MatheusParre/Bobinadeira/README.md

# Bobinadeira Horizontal

## Objetivo

Este projeto tem o objetivo de desenvolver uma bobinadeira horizontal e para tal, se encontram neste repositório remoto, todos os resultados obtidos com esse trabalho.

Neste projeto, foi necessário dimensionar todos os componente mecânicos e alguns elétricos (motor elétrico, por exemplo) agindo sempre de acordo com as normas nacionais e internacionais, a fim de padronizar e tornar este um projeto viável e possível no meio industrial atual.

## Monografia

Na monografia se encontram todos os cálculos realizados para o dimensionamento do maquinário de forma mais detalhada e técnica. Este documento foi desenvolvido baseado nas normas abnt atuais  para efeito de padronização e tambem para devida aceitação acadêmica.

Norma abnt p/ formatação do documento: :link: (*<https://www.normasabnt.org/novas-regras-abnt-2021/>*)

## Desenhos

Neste repositório, tambem estão armazenadas todas as **imagens dos componentes** (a maior parte no formato PDF ) cotados em escala, perspectiva e com seus respectivos cabeçalhos e dimensionamentos.

## Componentes

Neste diretório contém os todos as partes mecânincas que compõem o projeto, como por exemplo, **motor**, **mancal**, **rolamento** e **polia**. 
Este caminho também acompanha os arquivos no formato cad e pdf dos desenhos.
