MatheusParre/Bobinadeira/Monografia/Memorial de Cálculos.pdf

Construções de Máquinas I | Projeto: BOBINADEIRA HORIZONTAL
Aluno: Matheus Parré Rozatti
FATEC – Faculdade de Tecnologia de Sorocaba | 1° Semestre 2021

# CONSTRUÇÃO DE MÁQUINAS I

# BOBINADEIRA HORIZONTAL PARA FITAS DE AÇO

Professor: José Antônio Esquerdo Lopes

Aluno: Matheus Parré Rozatti Matrícula: 0030991921004

ANEXOS:

DESENHOS: DAS POLIAS, DO EIXO, DO CONJUNTO DE ACIONAMENTO

DOCUMENTOS CORRIGIDOS E COMENTADOS PELO PROFESSOR NAS VERIFICAÇÕES PARCIAIS:

(HISTÓRICO DO DESENVOLVIMENTO DO TRABALHO AO LONGO DO SEMESTRE)

### 1. DADOS DO PROJETO:

Bobinadeira Horizontal para Fitas de Aço

Dados: Espessura da fita: 0,6mm (h)

Largura da fita: 300mm (b)

Comprimento da fita: 170m (L)

Material da fita: 1020 SAE / ABNT

Velocidade de enrolamento: 0,7m/s

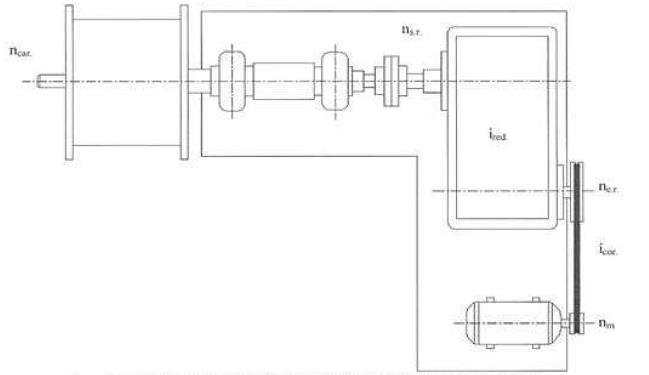
[picture p1: figure]

### 2. CÁLCULO DO RAIO MÍNIMO:

R ≥

H ( E− σesc)
2 .σesc

=

0,6 ( 2,1 . 10⁶− 2100)

2 .2100

= 29,97cm

Logo, R ≥ 29,97cm

### 3. CÁLCULO DA FORÇA DE DOBRAMENTO:

FD =

σesc . B . H
4

=

2100 . 0,6 . 300
4

= 945kgf

### 4. CÁLCULO DAS DIMENSÕES DA BOBINA:

Utilizando o raio do diâmetro interno d obtemos:

d = 29,47 x 2 = 58.94cm

### 5. CÁLCULO DO DIÂMETRO EXTERNO:

D = 2 x √
(l . ℎ)
π

+ r

2 = 2 x √
(17000 . 0,06)
π

+ 29,97² = 69,94cm

### 6. CÁLCULO DO DIÂMETRO MÉDIO:

Dm = D+d
2

=

69,94 +58,94
2

= 64,94cm

### 7. CÁLCULO DA POTÊNCIA ÚTIL OU EFETIVA:

Nu = 2 . v . Fd . D
75 . ( D+d)

=

2 . 0,7 . 945 . 69,94
75 . ( 69,94 + 59,94)

= 9,50 CV

### 8. CÁLCULO DO RENDIMENTO TOTAL:

ηROL = rendimento por mancal / rolamento = 0,99 ηCORR = rendimento na transmissão por correia = 0,95 ηRED = rendimento do redutor = 0,95
ηACOP = rendimento do acoplamento = 0,95

ηtotal = ηROL . ηROL . ηCORR . ηRED . ηACOP = 0,99 . 0,99 . 0,95 . 0,95 . 0,95 = 0,84

### 9. CÁLCULO DA POTÊNCIA FORNECIDA PELO DO MOTOR:

ηf = Nu
ηtotal =

9,50
0,84

= 11,31 CV

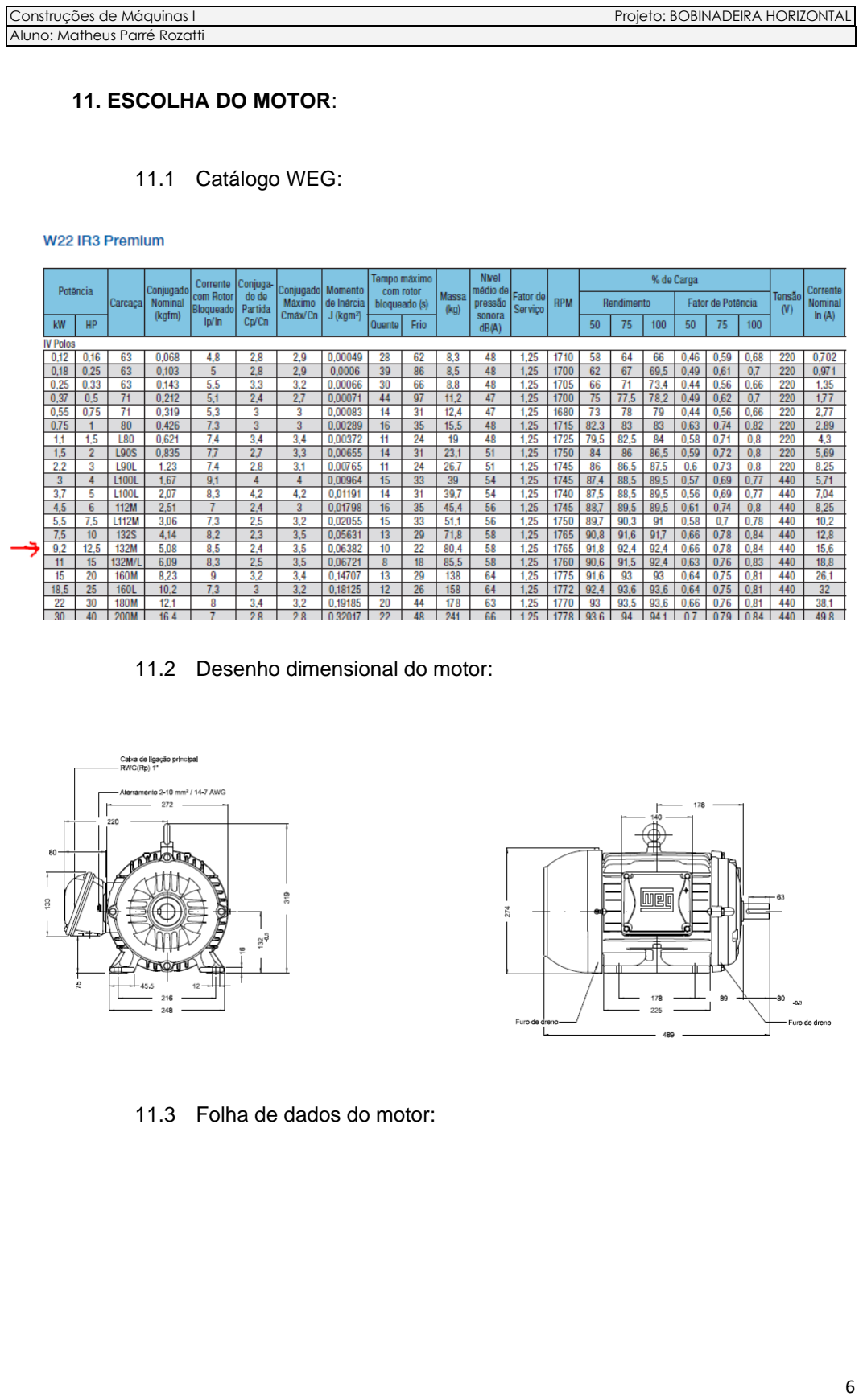
[picture p2: page 6]

### 11. ESCOLHA DO MOTOR:

11.1 Catálogo WEG:

11.2 Desenho dimensional do motor:

11.3 Folha de dados do motor:

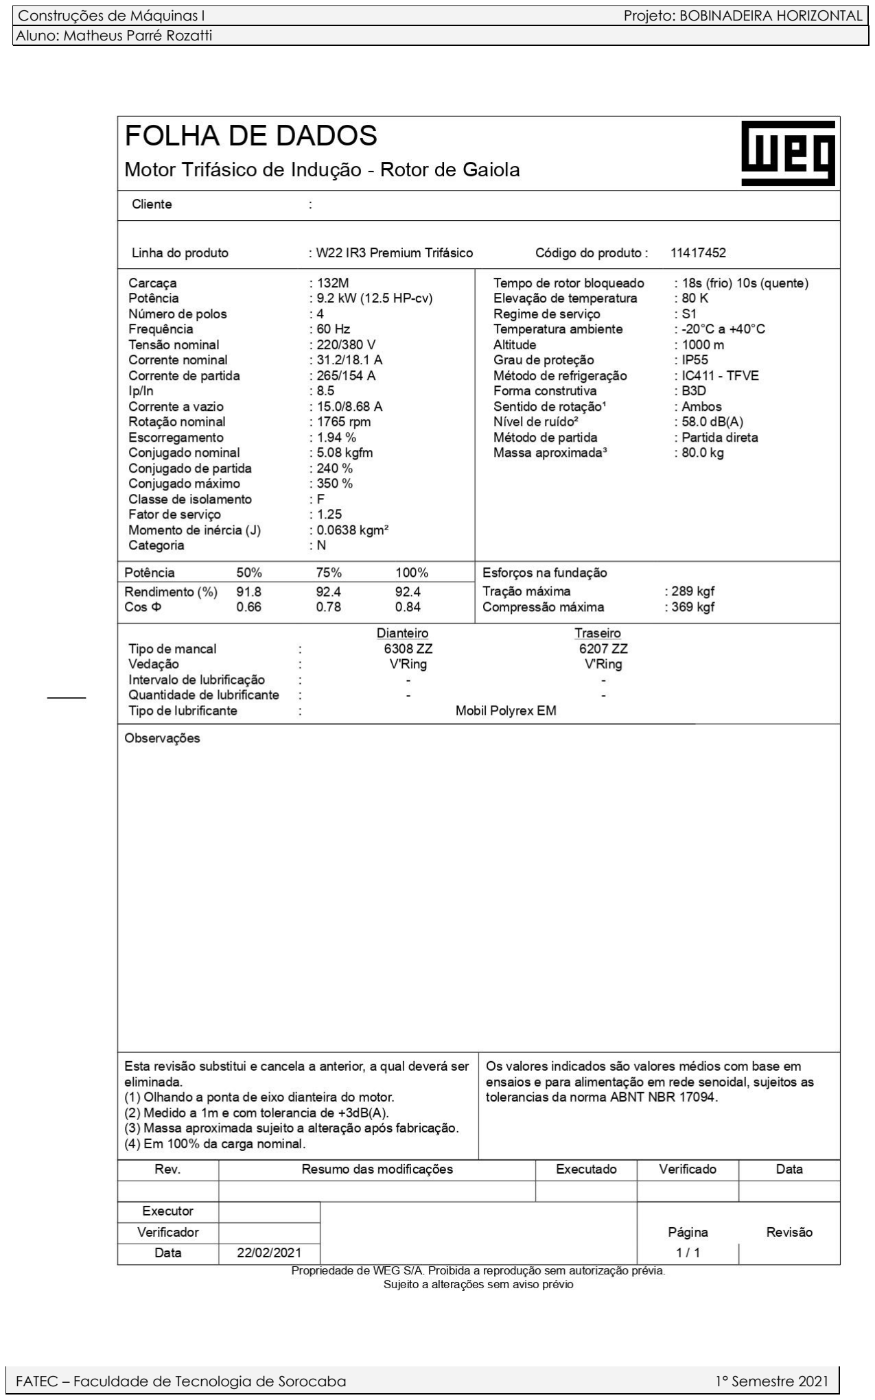
[picture p3: page 7]

### 12. CÁLCULO DA PARA DETERMINAR O REDUTOR A SER UTILIZADO NO

PROJETO:

12.1. DADOS:
Tipo de máquina: Bobinadeira
Ciclo de operação: Serviço contínuo até 12 horas / dia Potência do motor instalado: Pa = 9,2 kw Temperatura média do ambiente: 30 ºC
Altitude do ambiente: 800 m
Tipo de partida: direta
Frequência de partida: 10 / hora

Rotação do eixo de entrada do redutor: n1 Rotação do eixo de saída do redutor: n2

12.2. Determinação da relação de velocidade do redutor:

Para conseguir determinar a relação de velocidade do motor é necessário primeiro

achar n1 e n2

n1 = Rotação nominal do motor 3

=

1765
3

= 588,33 rpm

Para achar o n2 é necessário calcular a rotação do carretel:

n2= 19100 . v
dm

=

19100 . 0,7
64,94

= 20,59 rpm

Com isso já é possível determinar a relação de velocidade:

Ir =n1
n2

=

588,33
20,59

= 28,57

Por questões comerciais, da qual não existe um redutor de 28,57 e o mais próximo

é o 28, então é adotado o valor de 28 para ralação de velocidade.

12.3. Verificação da capacidade de Potência Mecânica do Redutor:
Pn = Pa x Fs ≤ Pr | Pr = | n1 n1 tabela
. p1

Alguns dados serão obtidos pelas tabelas da WEG Cestari, tabelas que apresentarei

ao decorrer dos cálculos. Vamos primeiro fazer o cálculo da capacidade de potência

mecânica do redutor em função da rotação de entrada (Pr), | para | isso | vamos

consultar a tabela da página 17.

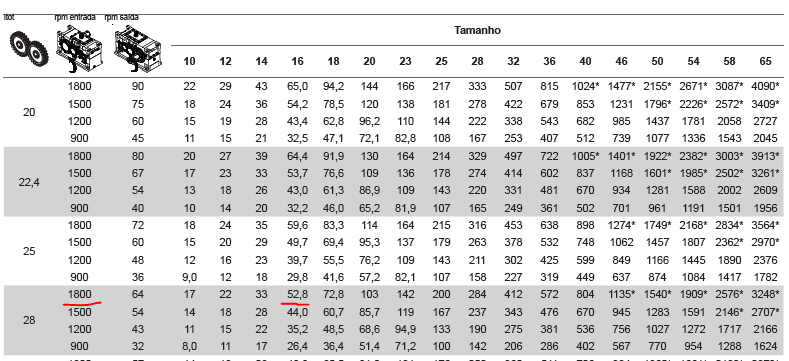
[picture p4: figure]

O valor de 1800 rpm foi escolhido por ser o mais próximo ao do motor já definido de

1765 rpm e, a carcaça de 16 foi escolhida pois é a que consegue suportar a

capacidade de torque do motor que calcularemos mais para frente, por conta disso

não utilizamos a de 14, já que ela não atende a condição de torque. Com esses

valores definidos podemos começar a resolver a equação.

Pr = n1 n1 tabela

x p1 = 588,33
1800

x 52,8 = 17,26

Para fazer o cálculo da potência nominal (Pn) será necessário olhar na tabela 1 de

fatores de segurança da página 7 do catálogo.

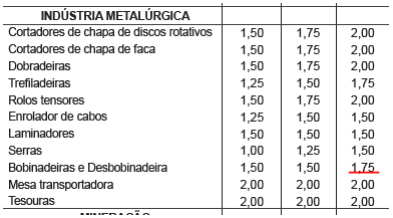
[picture p5: figure]

Sabendo que a bobinadeira vai trabalhar por 12 horas contínuas por dia é adotado o

fator de segurança (Fs) de 1,75.

Pn = Pa. Fs = 9,2 x 1,75 = 16,1 Kw

Pn ≤ Pr = 16.1 ≤ 17,26

Logo a carcaça de 16 atende a condição de potência mecânica do redutor.

12.4. Verificação da capacidade de Potência Térmica do Redutor:

Pt = Ptg x Fa x Fh ≥ Pa

Para acharmos os valores da potência térmica do redutor (Ptg), fator temperatura

ambiente (Fa) e o fator altitude (Fh) teremos que olhar em diversas tabelas, todas

serão apresentadas pela ordem escrita aqui.

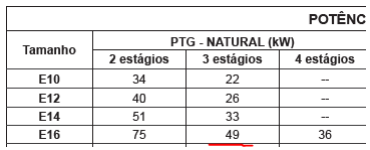
[picture p6: figure]

O Ptg foi retirado da página 10 usando como base o tamanho 16 da carcaça, já o Fa

foi retirado da página 8 utilizando como fato o dado que a temperatura ambiente é

de 30°C e por último o Fh também foi retirado da página 8, também utilizando de um

dado já apresentado que a altitude seria de 800m. Com todos esses dados, podemos

prosseguir com a equação.

Pt = Ptg x Fa x Fh = 49 x 0,85 x 1 = 41,65

Pn ≥ Pa = 41,62 ≥ 9.2

Logo, a potência térmica do redutor atende as necessidades.

12.5. Verificação da capacidade de torque do redutor em operação:

Como nossa carga é constante usaremos a seguinte equação:

Mn2 = 9550 x Pn
n2

= 9550 x 16,1
20,59

= 7467,46 Nm

Para verificar se o redutor atende as necessidades de torque usaremos a seguinte

equação:

M2 ≥ Mn2

M2 é um dado que devemos tirar da página 15 do catálogo.

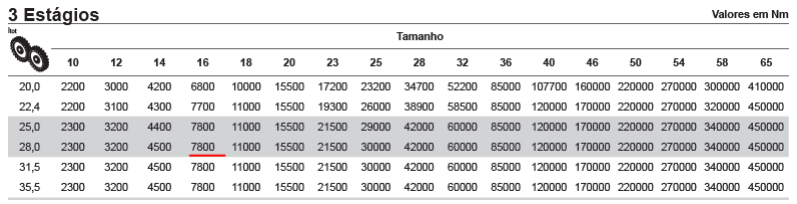
[picture p7: figure]

M2 ≥ Mn2 = 7800 ≥ 7467,46 Nm

Logo, o redutor atende a condição de torque.

12.6. Verificação da capacidade de torque do redutor na partida:

Como já dito, pelo fato de a carga ser constante usaremos a seguinte fórmula.

Mk2 adm = 2 . Mn2
Ff

O fator pico de partida (Ff) é um dado proveniente da página 8 do catálogo.

Utilizando o dado que já havia sido nos oferecido, que dizia que a partida era direta

e a bobinadeira trabalha de forma contínua por 12 horas, utilizamos um Ff de 1.2.

Mk2 adm = 2 . Mn2
Ff

=

2 . 7467,46
1,2

= 12445,77 Nm

Para realizarmos a conferência, se o redutor atende as necessidades utilizaremos a

seguinte equação:

Mk2 adm ≥ Mk2 máx.

Mas antes disso precisamos achar Mk2 máx.

Mk2 máx = 9550 x Pa
n2

x Fp

Fp é o fator de partida que deve ser retirado do catálogo, na página 8.

Como já havia sido dito que a partida é direta, vamos utilizar o Fp de 3.

Mk2 máx = 9550 x Pa
n2

x Fp = 9550 x 9,2
20,59

x 3 = 12801,36 Nm

Mk2 adm ≥ Mk2 máx = 12445,77 ≥ 12801,36

Como nesse caso as condições não foram atendidas faremos usaremos a seguinte

fórmula.

M2 ≥ Mk2 máx

Utilizaremos uma tabela, para achar o M2 que seja maior do que 12801,36.

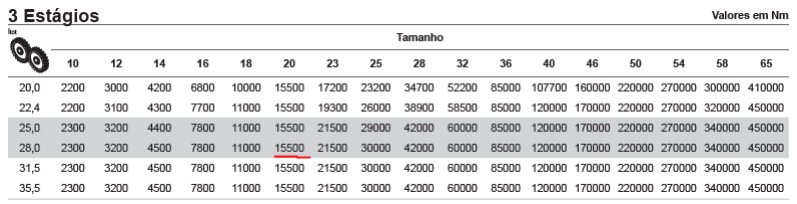
[picture p8: figure]

Logo, o redutor de 16 deverá ser substituído por um de 20.

12.7. Definição do código do redutor:

E – 20 – 3 – 29 – P – 19 – 0 – 0 – 0 - K

12.8. Desenho dimensional do redutor:

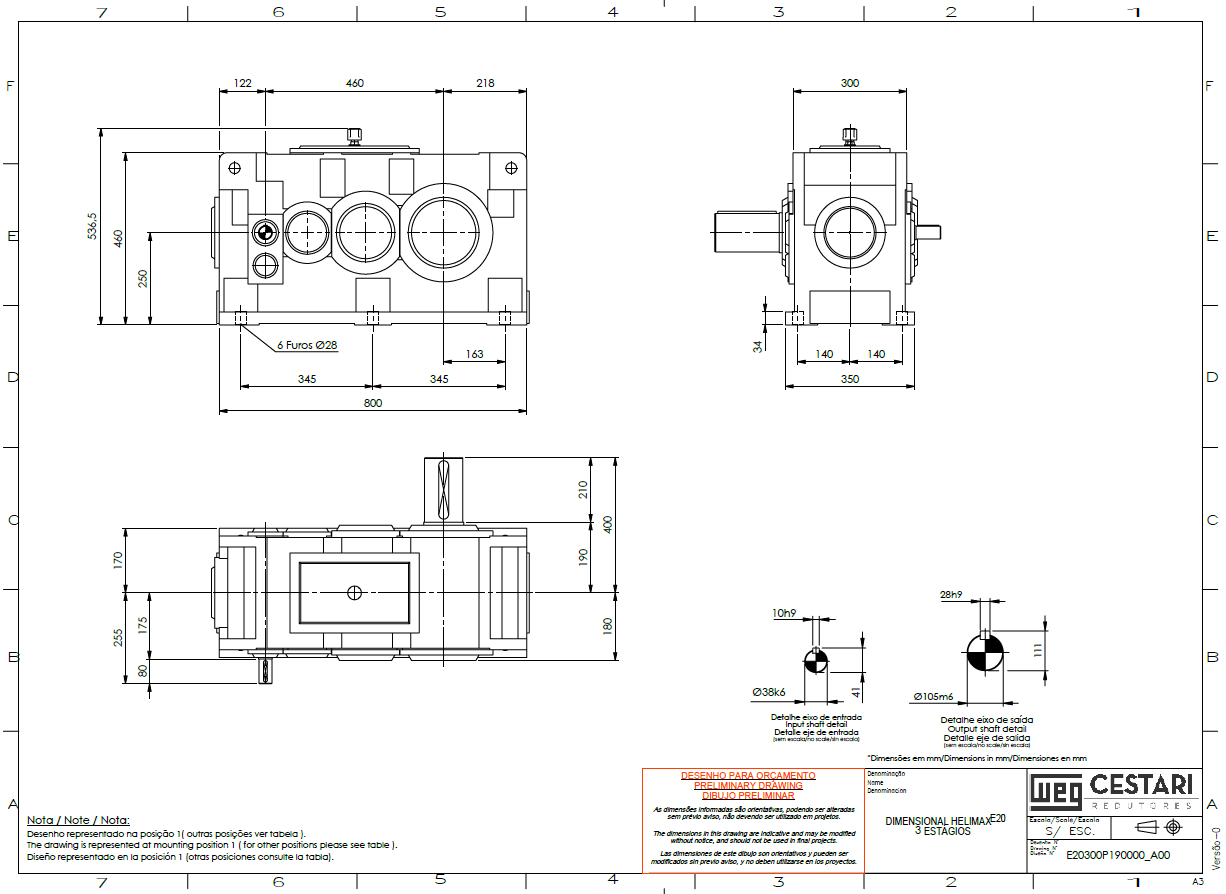
[picture p9: figure]

### 13. TRANSMISSÃO POR CORREIA EM “V”

13.1 Potência projetada:

HPP = HP × Fs

Para calcular a potência projetada será necessário utilizar o catálogo da Gates, para descobrir o fator de segurança adequado para a correia.

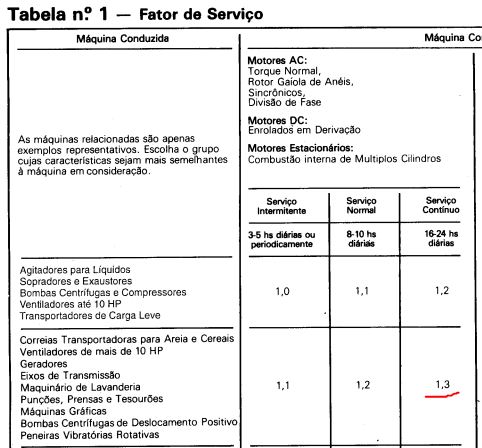
[picture p10: figure]

Como ela será utilizada por 12 horas contínuas todos os dias, o valor de fator de serviço escolhido foi 1,3.

HPP = HP × Fs = 12,5 x 1,3 = 16,5 HP

13.2 Escolha do perfil apropriado:

Utilizando o catálogo da Gates, utiliza-se um gráfico, que será apresentado a seguir, para poder definir qual o perfil adequado da correia, para isso se faz uma intersecção entra a potência projetada e o rpm do motor.

Sabendo que a HPP é 16,5 HP e o motor tem uma rotação de 1765 rpm, é possível descobrir o perfil correto.

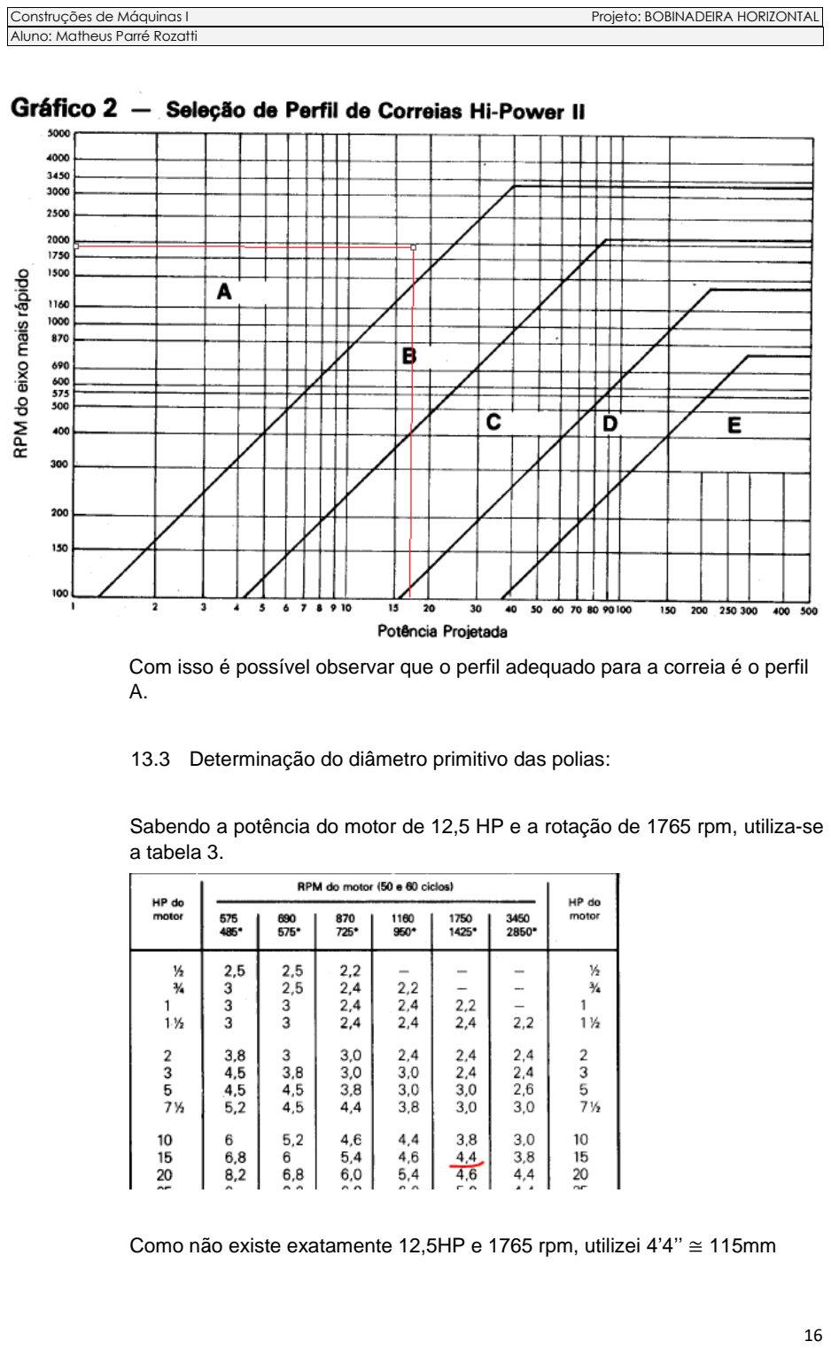
[picture p11: page 16]

Com isso é possível observar que o perfil adequado para a correia é o perfil A.

13.3 Determinação do diâmetro primitivo das polias:

Sabendo a potência do motor de 12,5 HP e a rotação de 1765 rpm, utiliza-se a tabela 3.

Como não existe exatamente 12,5HP e 1765 rpm, utilizei 4’4’’ ≅ 115mm

13.4 Cálculo experimental da distância entre centros:

Para realizar esse cálculo é necessário achar o diâmetro da polia menor, algo simples já que basta multiplicar o diâmetro da polia maior pela relação de transmissão. Ou seja 115 x 3 = 345mm

Com isso é possível determinar a distância experimental entre os centros.

C= 3d+D
2

=

3.115+345
2

= 345mm

13.5 Comprimento experimental da correia:

L = 2 x C + 1,57 x (D +d) +

(D−d)

2

4 x C

= 2 x 345 + 1,57 x (345 +115) + (345−115)

2

4 x 345

=

L = 1450,30mm

Utilizando a tabela 5 da Gates é possível se determinar o comprimento exato.

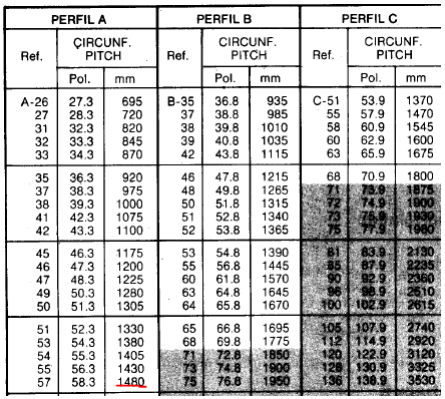
[picture p12: figure]

Como não existe um comprimento nominal de 1450,30, é adotado o valo acima. Com isso o comprimento correto é 1480mm.

13.6 Recalculando a distância entre centros:

A = Lc – 1,57 x (D – d) = 1480 – 1,57 x (345 – 115) = 1118,90mm

(D −d)
A

=

(345 −115)
1118,9

= 0,20

Utilizando a tabela 6 é possível descobrir o fator h.

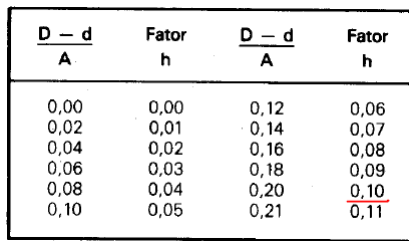
[picture p13: figure]

Dc = A−ℎ x (D−d)
2

=

1118,9 – 0,1 x (345−115)
2

= 547,50mm

13.7 Potência transmitida por correia:

Nessa parte será necessário extrair diversas informações do catálogo. Todas apresentadas a seguir.

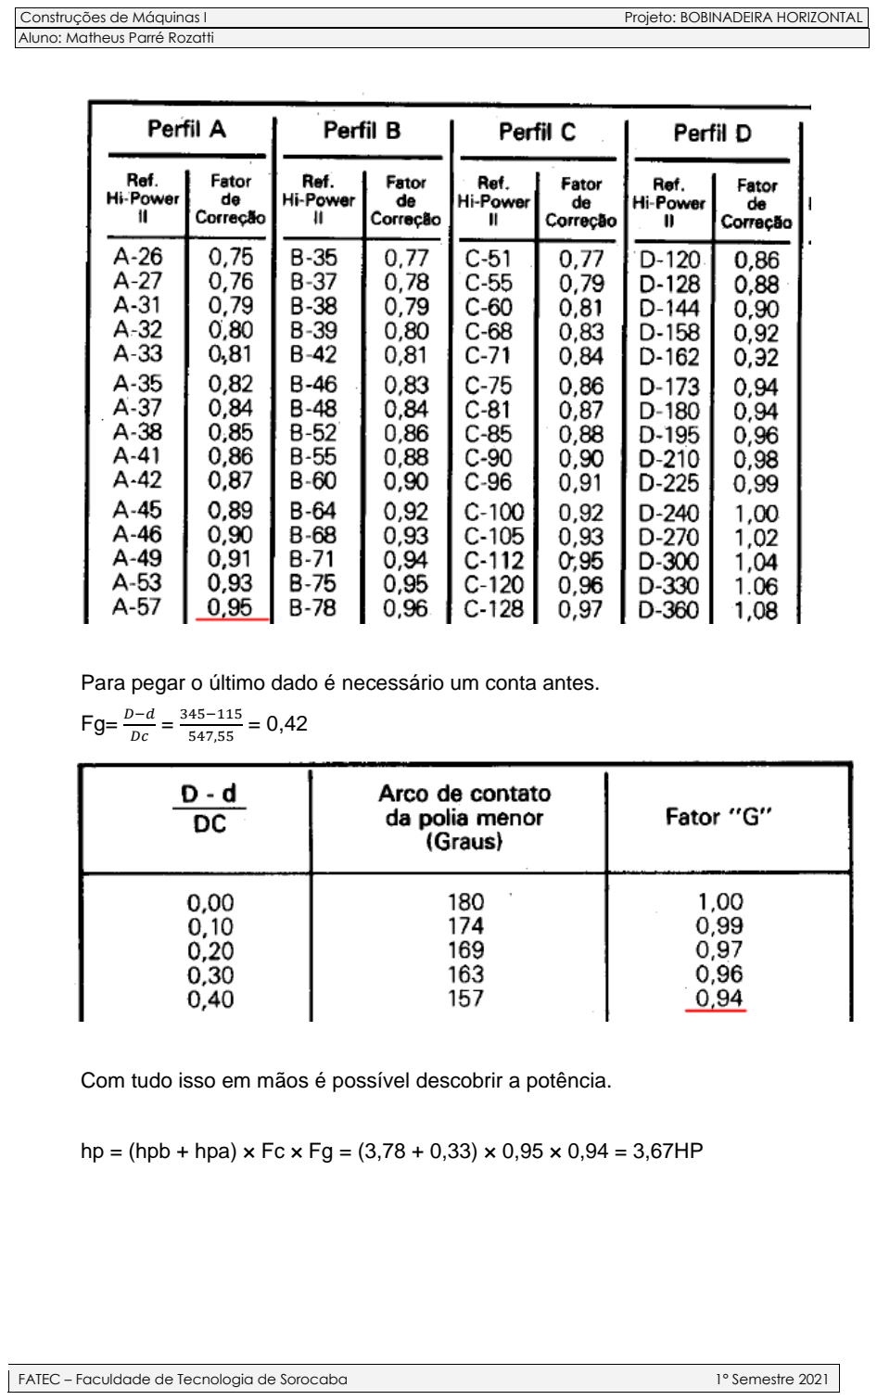
[picture p14: page 19]

Para pegar o último dado é necessário um conta antes.

Fg= D−d
Dc

=

345−115
547,55

= 0,42

Com tudo isso em mãos é possível descobrir a potência.

hp = (hpb + hpa) × Fc × Fg = (3,78 + 0,33) × 0,95 × 0,94 = 3,67HP

13.8 Número necessário de correias:

N = HPP
HP

=

16,25
3,67

= 4,4

(Vamos manter 4 conforme combinado com o professor)

13.9 Verificação da velocidade periférica das correias:

V = d . rpm maior
19100

=

115 . 1765
19100

= 10,62 m/s

13.10 Especificação da correia selecionada:

Com todos os cálculos feitos até agora, podemos concluir que, serão necessários os seguintes fatores.

4 correias, perfil A, ref. 57;
d = 115mm;
D = 345mm
Dc = 547,55mm

### 14. CÁLCULO PARA DIMENSIONAMENTO DA POLIA MOTORA:

14.1 Diâmetro externo:

Vai ser o tamanho da polia, que já foi calculado 115mm

14.2 Diâmetro interno:

Di = De – 2H = 115 – 2 x 13 = 89mm

O fator H foi retirado da apostila de desenho 2

14.3 Diâmetro do cubo:

Dc = 1,6 x de + 2 x t2 = 1,6 x 38 + 2 x 3,2 ≅ 68mm

Tanto de quanto t2 foram retirados da apostila de desenho 2 também.

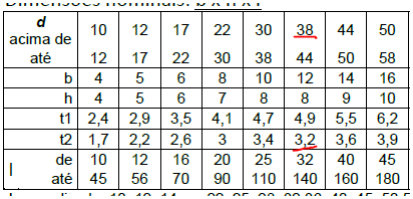
[picture p15: figure]

### 15. CÁLCULO PARA DIMENSIONAMENTO DA POLIA MOVIDA:

15.1 Diâmetro externo:

Já pré-defino anteriormente. 345mm

15.2 Diâmetro interno:

Di = De – 2 x h = 345 – 2 x 13 = 319mm

H foi retirado da apostila de desenho 2.

15.3 Diâmetro da alma:

Da = Di – 2 x K = 310 – 2 x 5 = 309mm

K foi retirado da apostila de desenho 2.

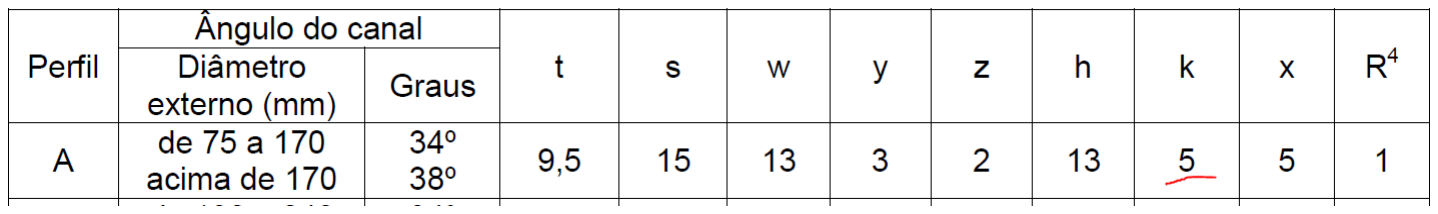
[picture p16: figure]

‘’

15.4 Diâmetro do cubo:

Dc = 1,6 x De + 2 x t2 = 1,6 x 38 + 2 x 3,2 ≅ 68mm

De e t2 foram retirados da tabela de chavetas da apostila de desenho 2.

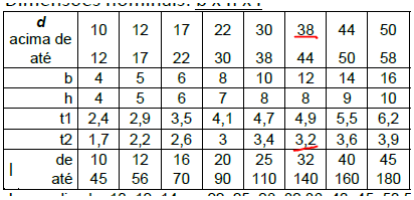
[picture p17: figure]

15.5 Diâmetro médio:

Dm = Da−Dc
2

=

309−68
2

= 188,5mm

15.6 Furos de alívio:

φ=

10⁵

588.33 x 315

= 0,54

Com isso basta olhar o gráfico para definir a alma.

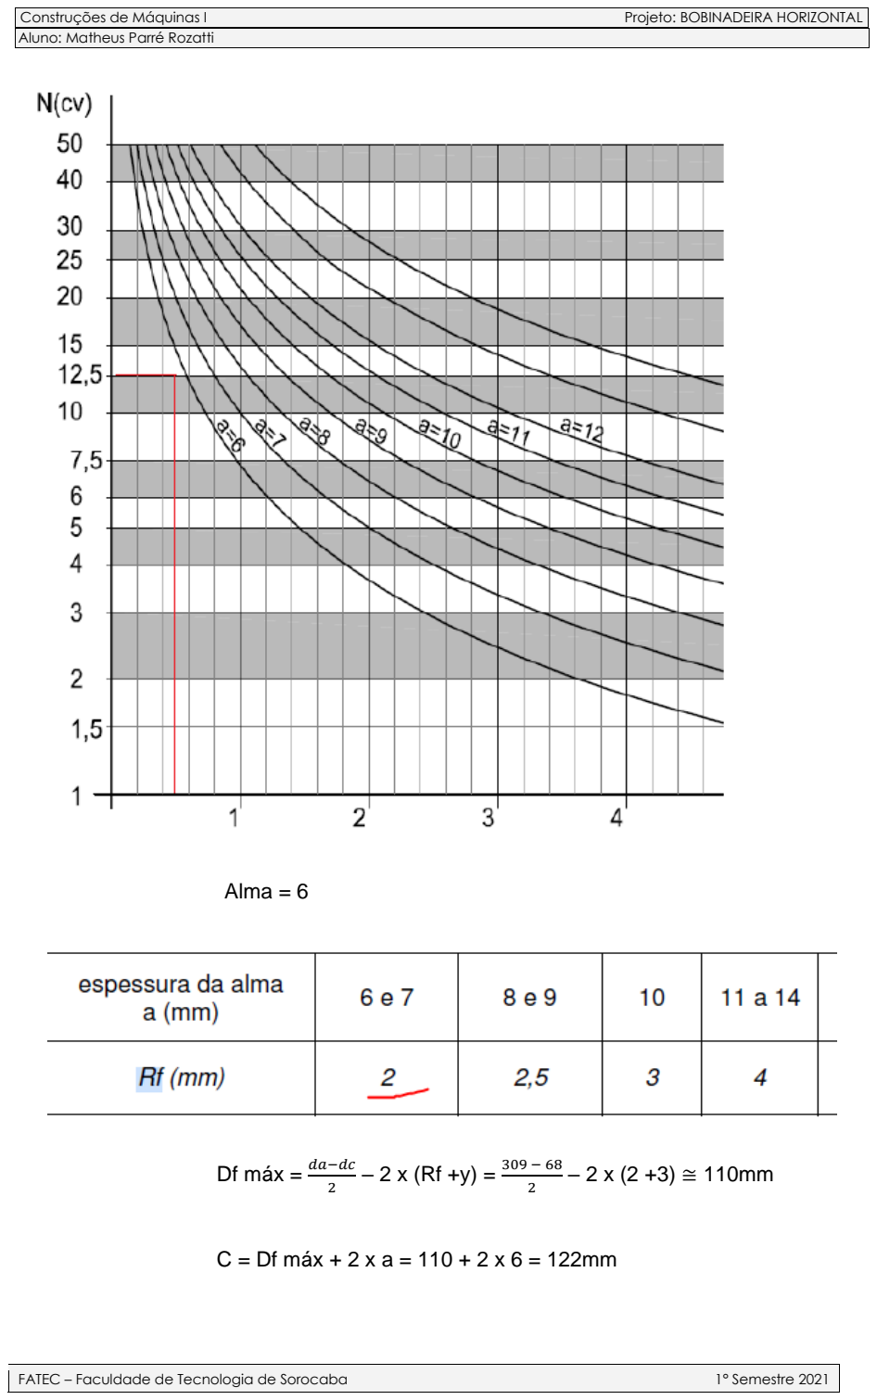
[picture p18: page 23]

Alma = 6

Df máx = da−dc
2

– 2 x (Rf +y) = 309 − 68
2

– 2 x (2 +3) ≅ 110mm

C = Df máx + 2 x a = 110 + 2 x 6 = 122mm

Senα =

Dfmáx +2 x a
dm

=

110 +2 x 6
188,5

= 0,71 = Senα⁻¹ 0,71 = 40,30°

Nf0 = 180
Senα

=

180
40,30

≅ 4 furos

15.7 % de material retirado:

Utilizando o software da Autodesk, Inventor fiz o desenho da polia com redução e sem, com os dados da massa antes e depois da redução, fui capaz de fazer o cálculo do material retirado.

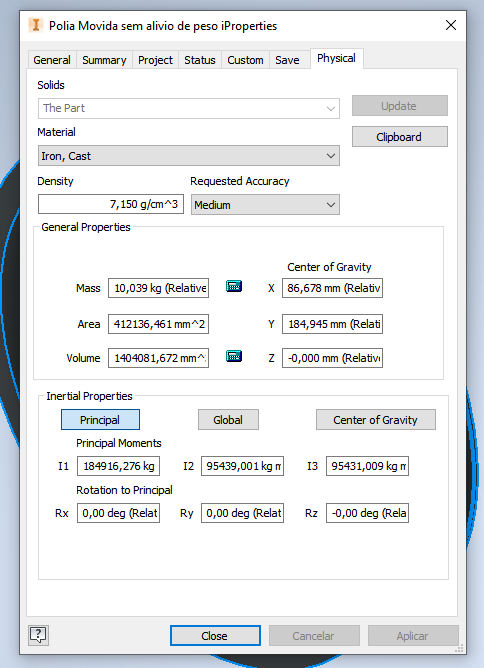
[picture p19: figure]

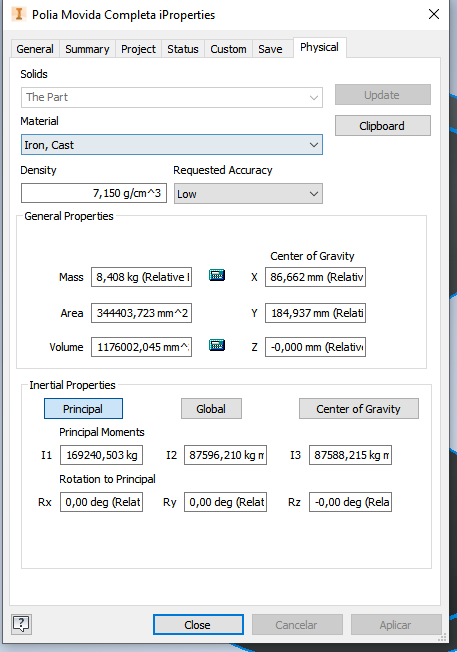
[picture p20: figure]

Fazendo uma regra de três é possível determinar a porcentagem.

10,039
8,408

=

100%
x

= 80,93%

Logo a redução de peso foi de 19,07%

### 16. PESOS DAS POLIAS:

16.1 Polia motora:

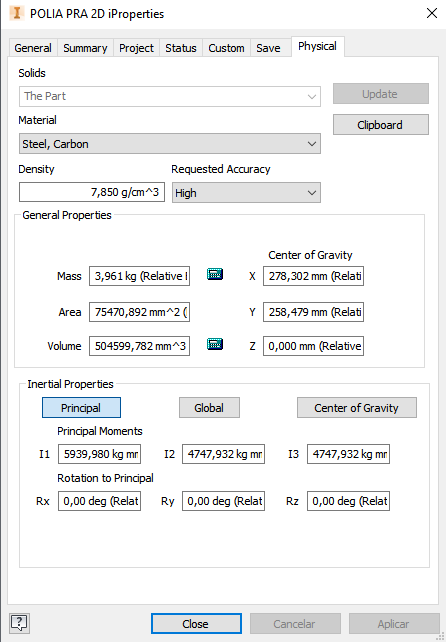
[picture p21: figure]

A polia tem 3,961 Kg de massa.

16.2 Polia movida:

A polia movida tem 8,408 Kg de massa, com a redução de peso.

### 17. DIMENSIONAMENTO DO EIXO:

17.1 Momento torsor no eixo: (diagrama)
Para dar início ao cálculo do momento torsor é necessário descobrir o peso da bobina e, para isso, utilizaremos a seguinte equação com os seguintes dados:
h x b x L = 0,06 x 30 x 17000 = 30600 cm³
30600 x peso do aço = 30600 x 7,87 = 240,822 Kgf

Conforme combinado com o professor o peso do carretel seria 30% da bobina
30% de 240,822 = 72,247 Kgf

Com isso já calculado seguiremos com o cálculo do momento torsor.

MT = 716200 Mn
n

= MT = 716200 12,5
20,59

= 434798,446 Kgf.mm

Agora vamos somar as massas da bobina e carretel para colocar no diagrama
240,822 + 72,247 = 313,069

Sabendo que isso será apoiado em duas partes esse valor deve ser dividido.

313,069
2

= 156,545 Kgf

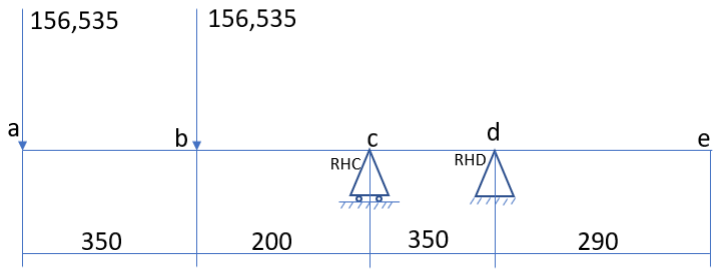
[picture p22: figure]

17.2 Forças atuantes no eixo:

Agora faremos a somatória das forças para achar, as forças que atuam em Pc e Pd. O valor de 109 será explicado mais adiante.

∑F = 0
−156,535 − 156,535 + Pc + Pd − 109 = 0 = Pc + Pd = 422,070 Kgf

Isolando o Pd obtemos:

∑ Md = 0

- (156,535 x 900) – (156,535 x 550) + (Pc x 350) + (Pd x 0) + (109 x 350)

Pc = 475,35 Kgf

Com isso podemos obter Pd.

Pc + Pd = 422,070
475,35 + Pd = 422,070

Pd = -53,250

17.3 Plano vertical: (diagrama)

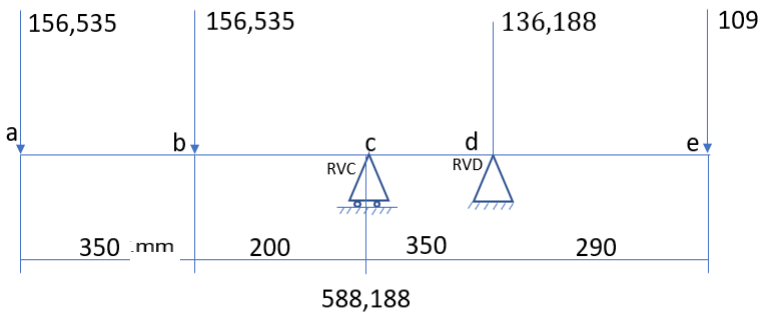
[picture p23: figure]

∑MA = −(156,535 x 0) = 0
∑MB = −(156,535 x 350) = -54787,25 Kgf
∑MC = −(156,535 x 550) − (156,535 x 200) =-117401,250 Kgf ∑MD = −(156,535 x 900) − (156,535 x 550 ) + (558,188 x 350) = -31609,950 Kgf
∑ME = −(156,535 x 1190) − (156,535 x 840 ) + (558,188 x 640) −(136,188 x 109) = ≅ 0

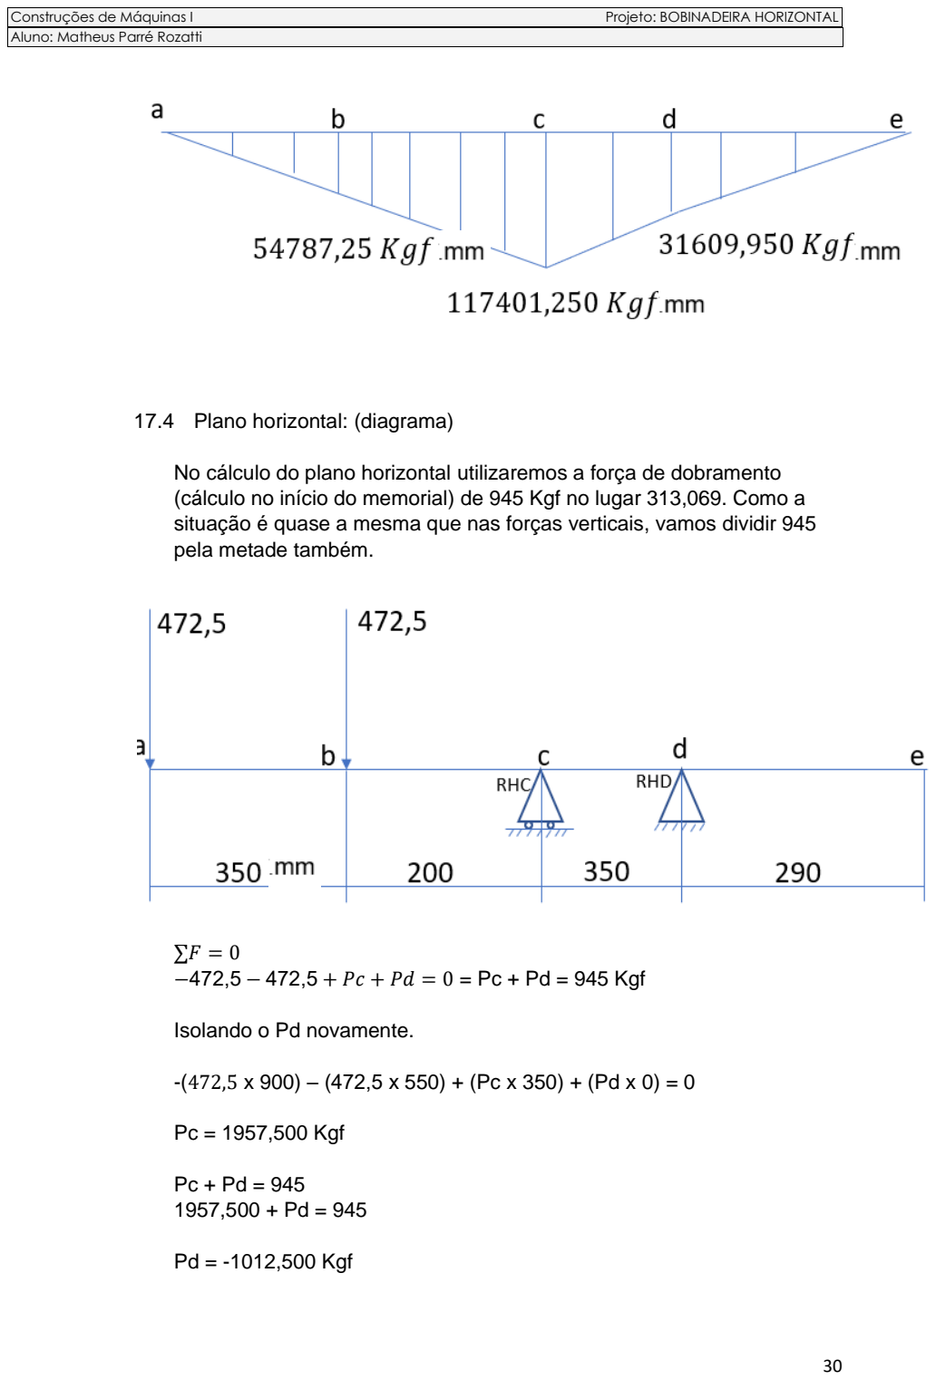
[picture p24: page 30]

17.4 Plano horizontal: (diagrama)

No cálculo do plano horizontal utilizaremos a força de dobramento (cálculo no início do memorial) de 945 Kgf no lugar 313,069. Como a situação é quase a mesma que nas forças verticais, vamos dividir 945 pela metade também.

∑F = 0
−472,5 − 472,5 + Pc + Pd = 0 = Pc + Pd = 945 Kgf

Isolando o Pd novamente.

-(472,5 x 900) – (472,5 x 550) + (Pc x 350) + (Pd x 0) = 0

Pc = 1957,500 Kgf

Pc + Pd = 945
1957,500 + Pd = 945

Pd = -1012,500 Kgf

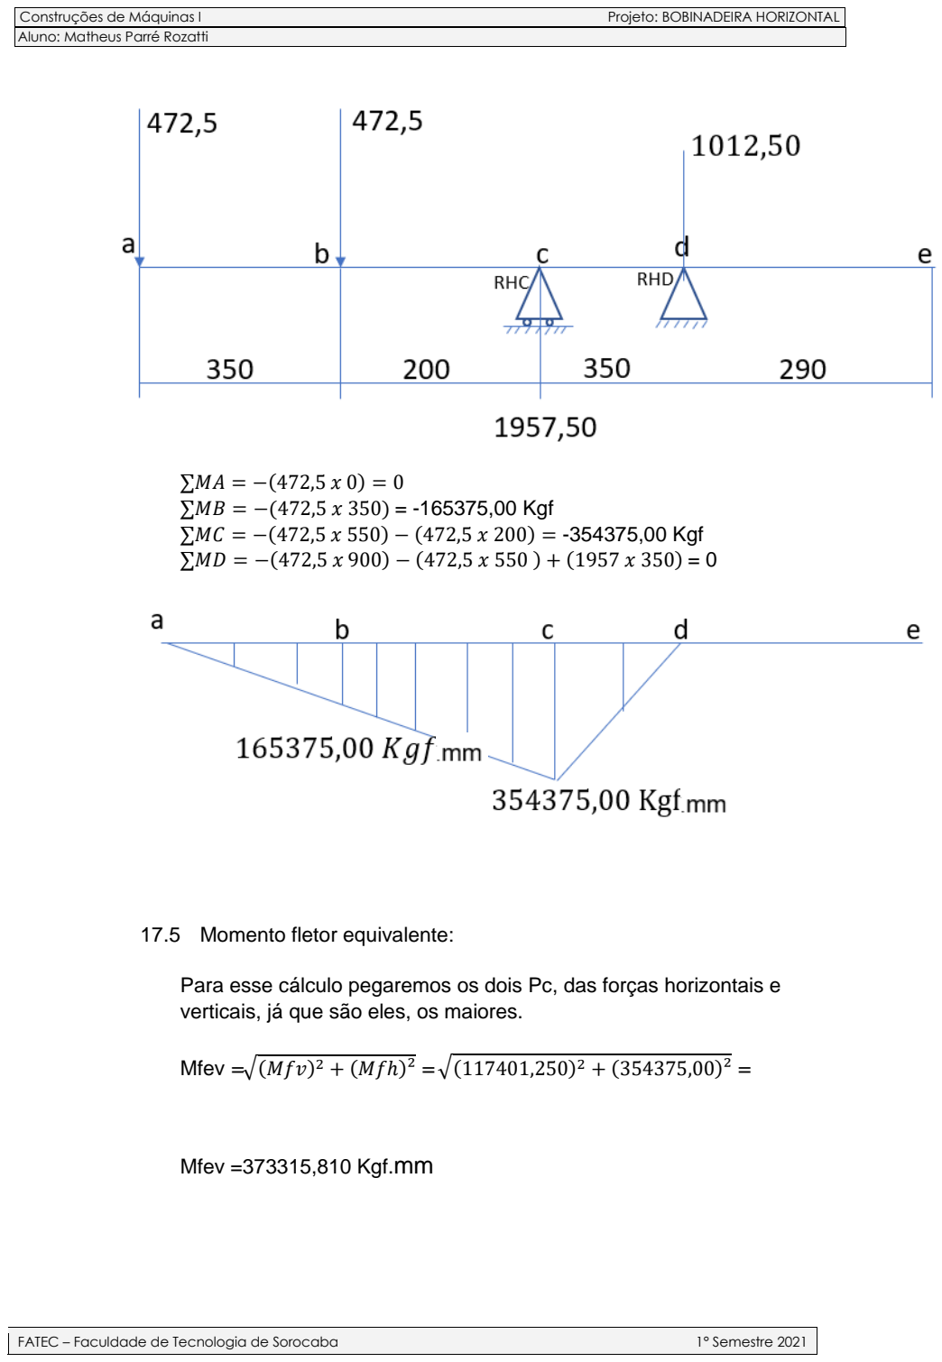
[picture p25: page 31]

∑MA = −(472,5 x 0) = 0
∑MB = −(472,5 x 350) = -165375,00 Kgf
∑MC = −(472,5 x 550) − (472,5 x 200) = -354375,00 Kgf ∑MD = −(472,5 x 900) − (472,5 x 550 ) + (1957 x 350) = 0

17.5 Momento fletor equivalente:

Para esse cálculo pegaremos os dois Pc, das forças horizontais e verticais, já que são eles, os maiores.

Mfev =√(Mfv)

2 + (Mfℎ)² = √(117401,250) 2 + (354375,00)²
=

Mfev =373315,810 Kgf.mm

17.6 Dobrovolski:

O valor de 63 Kgf/mm foi retirado da seguinte tabela.

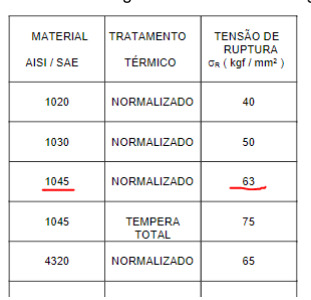
[picture p26: figure]

σI = 0,333 x σr = 0,333 x 63

σI = 20,979 kgf/mm²

σIII =

σI
3,8

=

20,979
3,8

= 5,521 kgf/mm2

α =

σIII
σI

=

5,521
20,979 =

α = 0,263

Aqui, vamos dividir o cálculo do diâmetro do eixo em duas partes. Pois conforme pedido do professor, é necessário ter um stop para o carretel, para isso o eixo terá 2 diâmetros, do ponto A ao 410mm será um diâmetro e, após isso outro diâmetro até o ponto E.

Começaremos do ponto A ao até 410mm

Para isso será necessário calcular o momento equivalente exercido entre esses 2 pontos.

156,535 x 410 = 64179,350 Kgfmm (Vertical)
472,5 x 350 = 193725,00 Kgfmm (Horizontal) Meqv = √64179,350² + 193725,00²

Meqv = 204079,310 Kgfmm

d = √
√Meqv²+(∝. MT)
2
0.1 . σ flexão

3

= √
√204079,310 ²+(0,263. 434798,446 )
2
0.1 . 5,521

3

d = 75,109mm

Agora do 410mm até o ponto E.

410mm – E = (-156,53) + 588,188 + (-136,188) = 295,465 Kgfmm (Vertical) 295,465 x 780mm = 230462,70 Kgfmm (Vertical)

410mm – E = (-472,5) + 1957,5 + (-1012,5) = 472,5 Kgfmm
472,5 x 780 = 368550,00 Kgfmm

Meqv = √230462,70 ² + 368550,00²

Meqv = 434674,773 Kgfmm

d = √
√Meqv²+(∝. MT)
2
0.1 . σ flexão

3

= √
√434674,773 ²+(0,263. 434798,446 )
2
0.1 . 5,521

3
= 93,374 mm

### 18. DIMENSIONAMENTO DA CHAVETA PARA CARRETEL:

A chaveta que vamos utilizar é uma SAE 1040, com isso seguiremos a tabela abaixo para os cálculos.

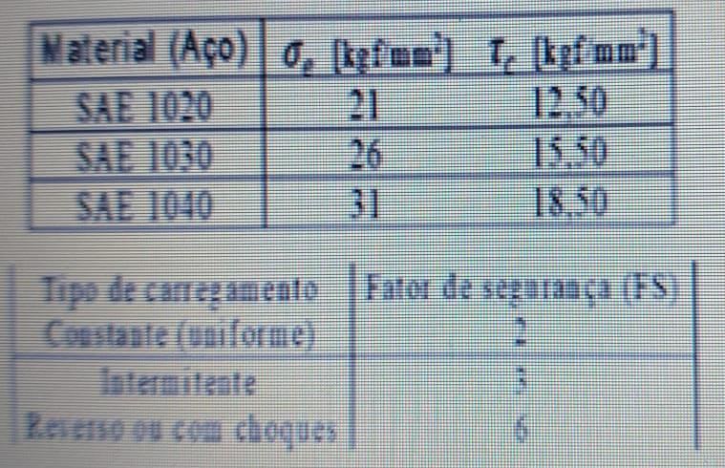
[picture p27: figure]

Para achar o diâmetro final do eixo utilizaremos a seguinte equação:

ØFinal = 2 x (R + t1) | R= Raio do eixo
Para obtermos t1 utilizamos a apostila de desenho 2.

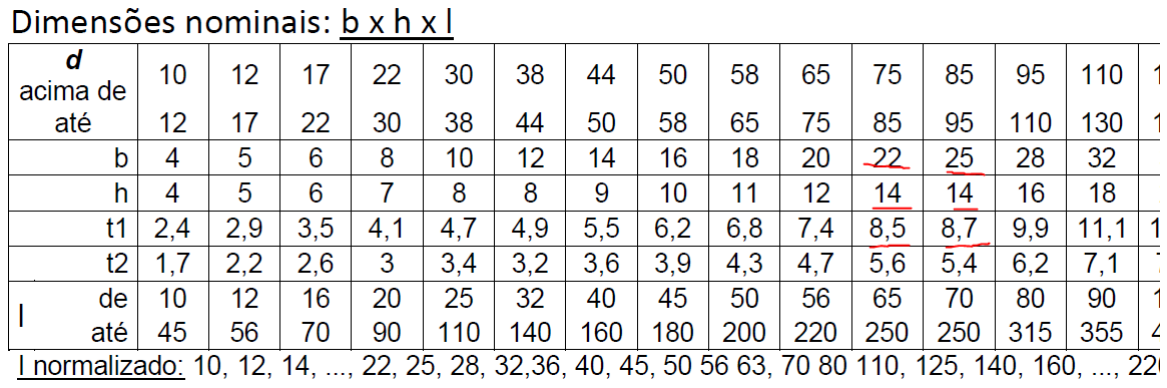
[picture p28: figure]

ØFinal = 2 x (37,554 + 8,5) | ØFinal = 2 x (96,687 +8,7)

ØFinal = 92,108mm do ponto A até 410mm ØFinal = 110,774 Dos 410mm até o ponto E

Como aconselhado pelo professor na aula do dia 14/06/21, os últimos 185mm, que representam o quanto o eixo ficará dentro do acoplamento, será menor que os Ø110m, por conta disso o Ø do eixo dentro do acoplamento será de Ø105mm.
A nova conta da chaveta vai estar na própria parte dedicada a ela, porém como já se sabe que a escolhida será a de cisalhamento, vou apenas demonstrar ela. Deixarei indicado em amarelo, como fiz neste tópico.

Para termos um eixo normalizado utilizaremos o valor de Ø95 mm para o eixo do ponto A até 410mm. E do 410mm até os 615mm Ø110mm.

Utilizando a primeira tabela desse tópico faremos as seguintes equações, para assim achar o esmagamento e o cisalhamento.

σe =

σe
Fs

=

31
2

= 15,5 para esmagamento

re =

re
Fs

=

9,25
2

= 9,25 para cisalhamento

18.1 Dimensionamento para o esmagamento:

O h dessa conta foi retirado da tabela de chavetas já apresentada acima, mas vale lembra que o eixo que adotamos foi de 95mm.

4 x Mt
ℎ x D eixo x σe

=

4 x 434738,446
16 x 100 x 15,5

= 73,820 mm

18.2 Dimensionamento para o cisalhamento:

O b também foi retirado da tabela.

2 x Mt
b x D eixo x re

=

2 x 434738,446
28 x 95 x 9,25

= 35,316mm

Como o maior foi o por esmagamento, então utilizaremos ele, porém vamos utilizar um de 75mm ao invés de 73,820mm.

A chaveta escolhida então foi a DIN 6885 SAE 1040 28x16x75mm

19.DIMENSIONAMENTO DA CHAVETA PARA O ACOPLAMENTO:

19.1 Dimensionamento para o esmagamento:

Lembrando que o eixo foi normalizado em 110mm.

| 4 x Mt
ℎ x D eixo x σe
| = 4 x 434738,446 18 x 110 x 15,5 = 56,670 mm

Cálculo da nova chaveta 14/06/21

| 4 x 434738,446
16 x 105 x 15,5
| =66,78mm
19.2 | Dimensionamento para o cisalhamento:

2 x Mt
b x D eixo x re

=

2 x 434738,446
32 x 110 x 9,25

= 26,708 mm

Portanto também utilizaremos uma chaveta de esmagamento, porém com um l normalizado de 70mm

DIN 6885 SAE 1040 28x16x70mm

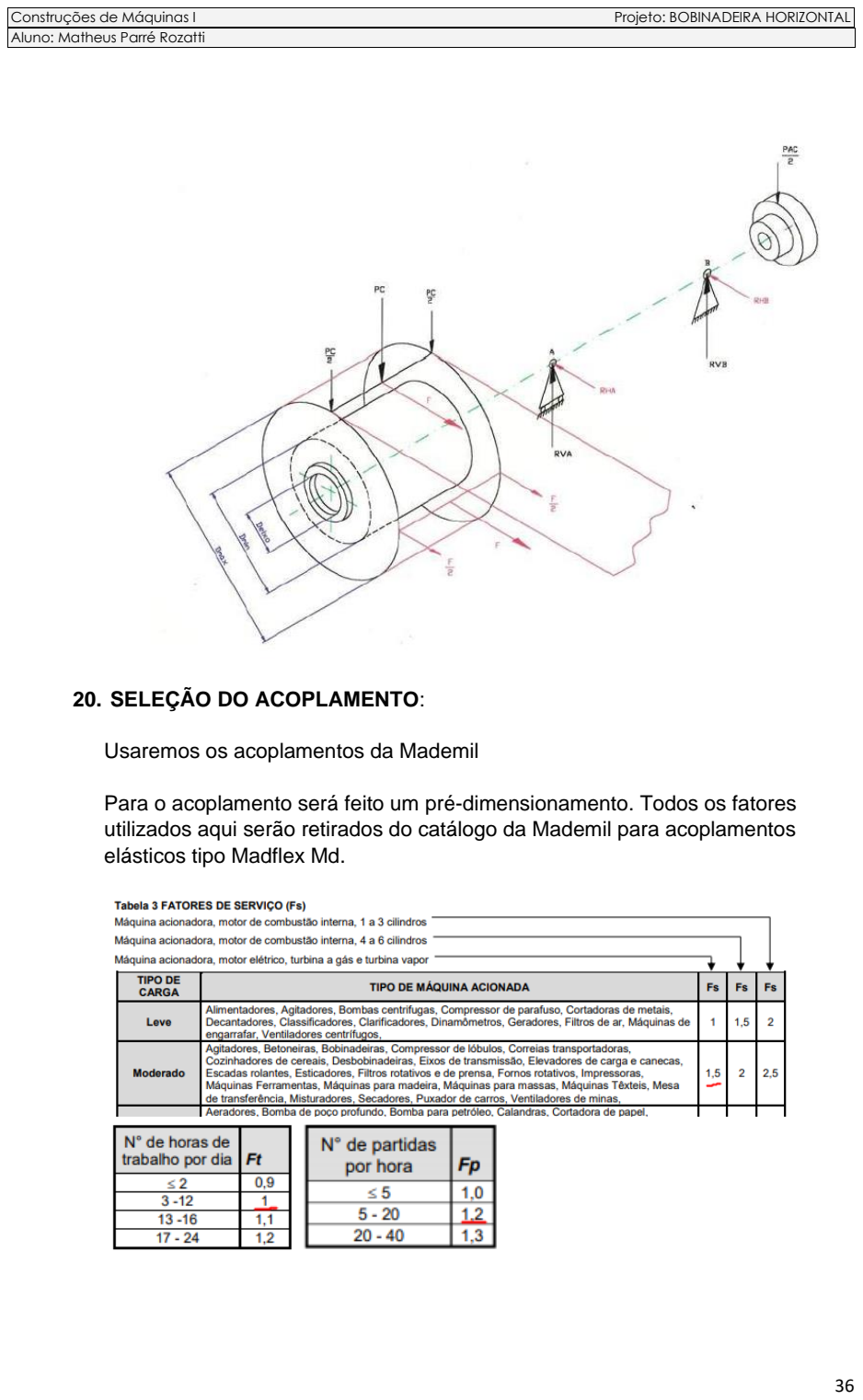
[picture p29: page 36]

### 20. SELEÇÃO DO ACOPLAMENTO:

Usaremos os acoplamentos da Mademil

Para o acoplamento será feito um pré-dimensionamento. Todos os fatores utilizados aqui serão retirados do catálogo da Mademil para acoplamentos elásticos tipo Madflex Md.

Fc = Fs x Ft x Fp = 1,5 x 1 x 1,2 = 1,8

Com isso olhamos na tabela, utilizando o valor de 1,8 e a rotação do motor.

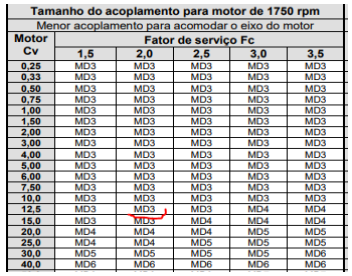
[picture p30: figure]

Como não existe 1,8, adotei o valor de Fc como 2, portando a partir desse pré-dimensionamento o acoplamento escolhido foi o MD3.

Agora vamos utilizar outro método.

Torque = 716,2 x N x Fc
n
N= É potencial útil do motor que nesse caso é 12,5 ÷ 0,99² ÷ 0,97 = 12,091 Cv

Torque = 716,2 x N x Fc
n

= 716,2 x ¹²,091 x 1,8
20,59

= 757,037 Kgf

20,59 é a rotação do carretel, que foi calculado no início do memorial.

Com isso sabemos o torque necessário para a bobinadeira, olhando na tabela percebe-se que, o MD3 não atende as condições de torque portanto, iremos utilizar o modelo MD15.

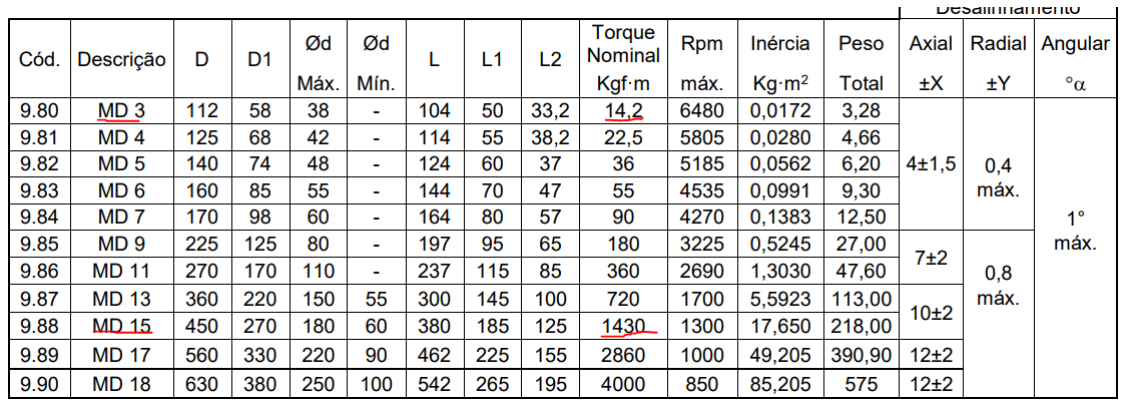
[picture p31: figure]

Com o acoplamento escolhido, utilizamos o peso 218 na parte de diagrama de forças, divido pela metade temos o valor de 109 utilizado nas contas.

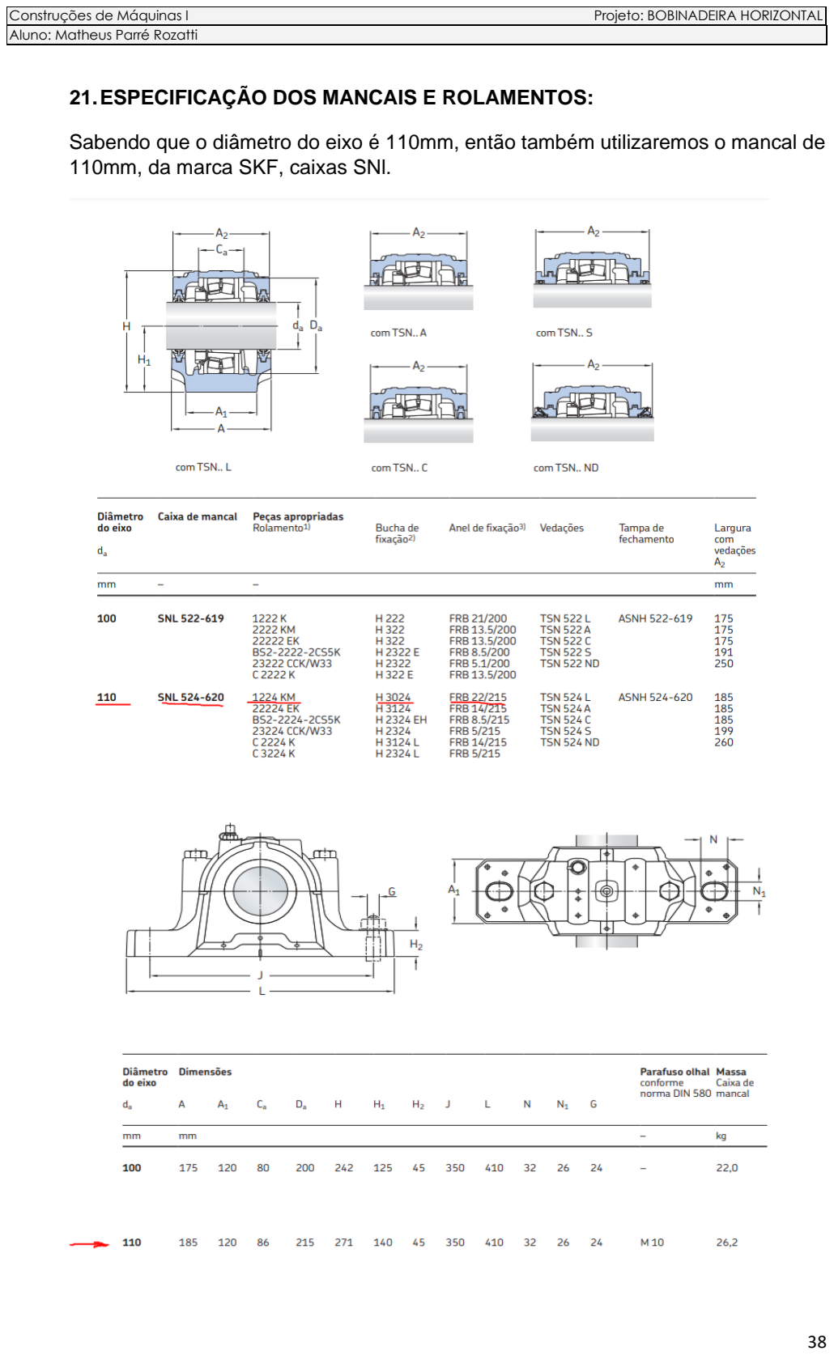
[picture p32: page 38]

21.ESPECIFICAÇÃO DOS MANCAIS E ROLAMENTOS:

Sabendo que o diâmetro do eixo é 110mm, então também utilizaremos o mancal de 110mm, da marca SKF, caixas SNl.

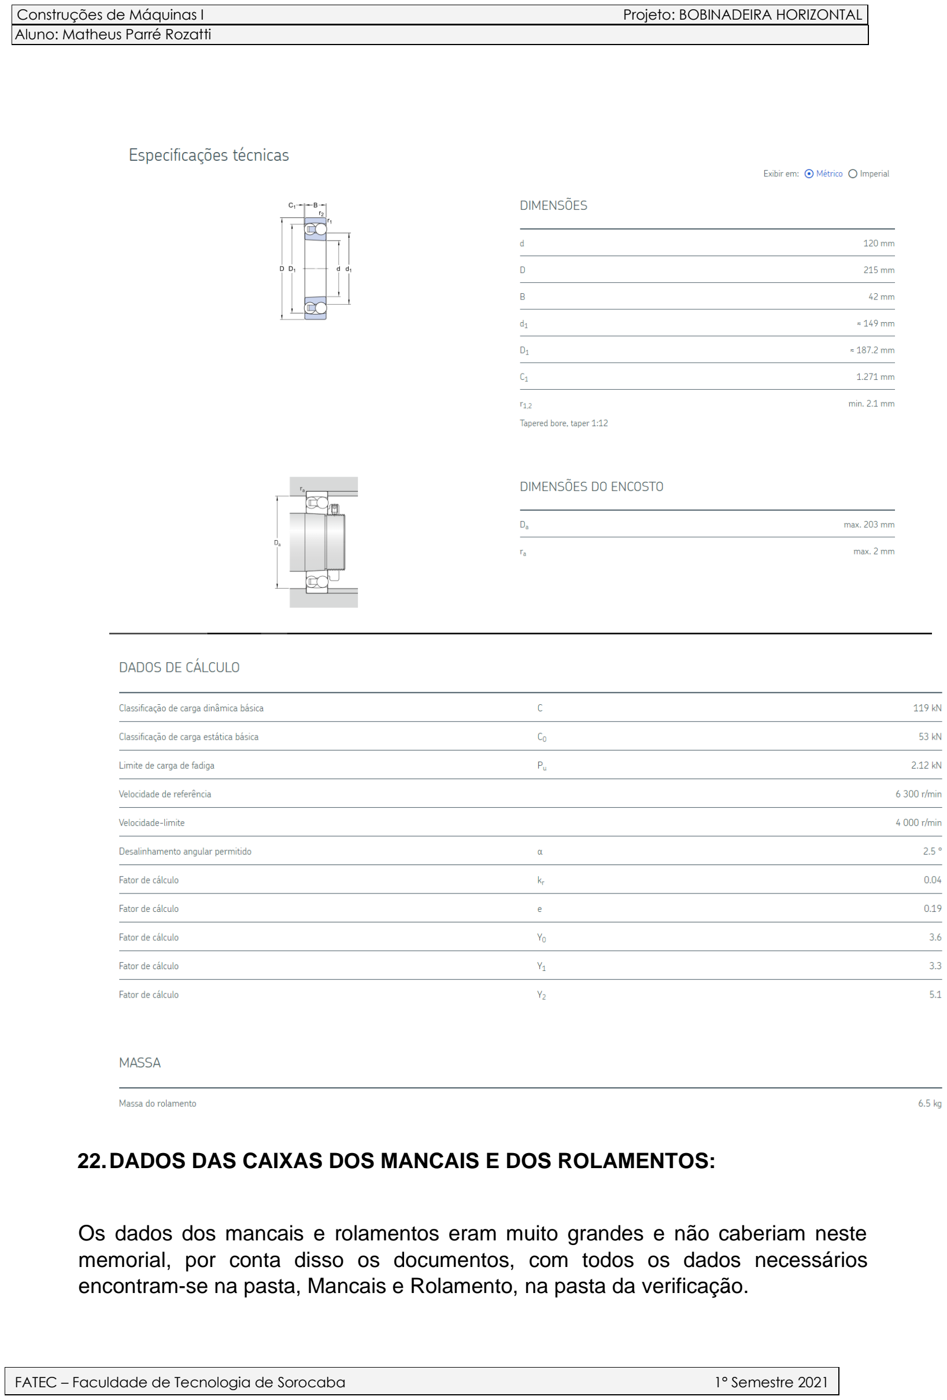
[picture p33: page 39]

22.DADOS DAS CAIXAS DOS MANCAIS E DOS ROLAMENTOS:

Os dados dos mancais e rolamentos eram muito grandes e não caberiam neste memorial, por conta disso os documentos, com todos os dados necessários encontram-se na pasta, Mancais e Rolamento, na pasta da verificação.

23.CÁLCULO DA VIDA DO ROLAMENTO:

RHc = 588,188 kgf
RVc = 1957,50 Kgf
P = √ 588,188² + 1957,50² = 2043,960kgf

D = mm
Rotação = 20,59 rpm

L = 20,59 × 60 × 30.000 = 37,062 milhões de rotações 1.000.000

L = (C/P)

p

onde: L = vida em milhões de rot. C= cap. dinâmica do rolam.
P = carga equivalente
Lh = vida em horas
P = 2043,960 kgf . 10 = 20439,597 KN
p
= fator p/ rol. de esferas

‘ C = √L

3
. P
C = √37,062 ³
. 20439,597

C = 68147,29 N C= 68,15 KN

Como neste caso, a caixa de mancal SNL 524-620 já nos diz, qual devem ser os rolamentos devem ser utilizados nela e sabemos que o primeiro, que é o 1224KM (119KN) supre as necessidades com tranquilidade, vamos refazer o cálculo para saber quantas horas e milhões de rotações ele suporta.

L=(

119000
20439,597

)³

L= 197.34 vida em milhões de rotações.

Agora vamos descobrir a vida em horas.

197,34 = 20,59 × 60 × Lh = 19734398,69= 20,59 x 60 x Lh 1.000.000

Lh = 159740,96 Horas.

24.OUTRAS INFORMAÇÕES SOBRE O PROJETO:

ANEXOS:

DESENHOS: DAS POLIAS, DO EIXO, DO CONJUNTO DE ACIONAMENTO

DOCUMENTOS CORRIGIDOS E COMENTADOS PELO PROFESSOR NAS VERIFICAÇÕES PARCIAIS:

(HISTÓRICO DO DESENVOLVIMENTO DO TRABALHO AO LONGO DO SEMESTRE)
