MatheusParre/Bobinadeira/Componentes/Motor/Carcaça/132M_LEFT/132M_LEFT.DXF

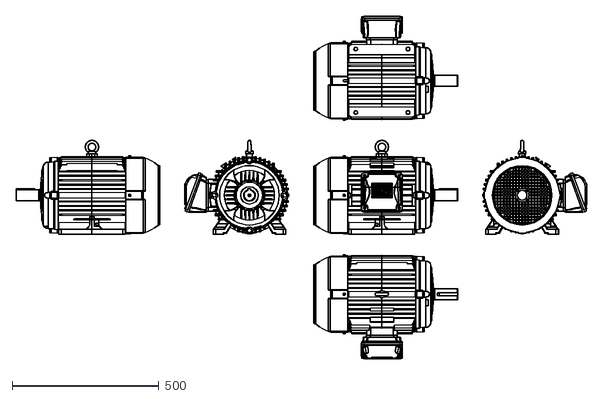
[picture p67: CAD file, 2021-09-08]
Componentes/Motor/Carcaça/132M_LEFT/132M_LEFT.DXF
1942.7 x 1166.9
