MatheusParre/Bobinadeira/Componentes/Motor/Carcaça/132M_RIGHT/132M_RIGHT.DXF

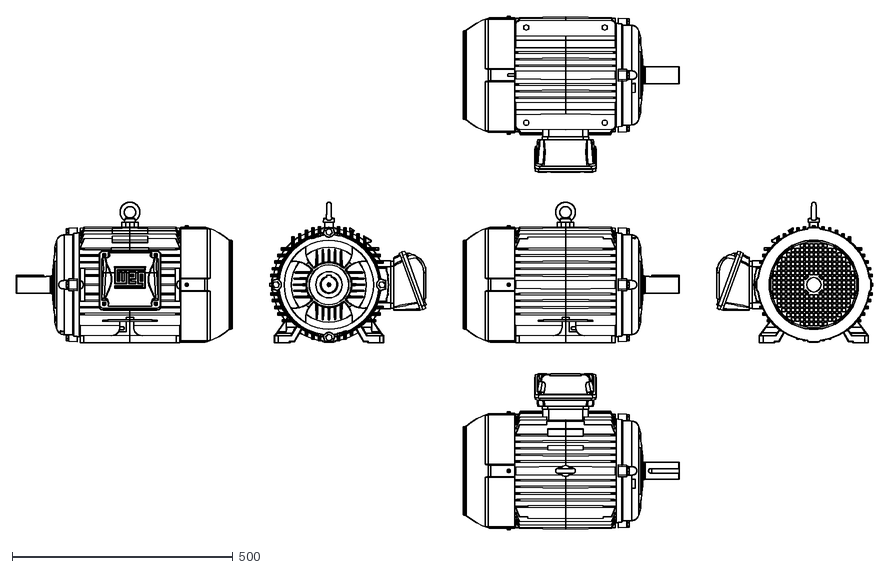
[picture p68: CAD file, 2021-09-08]
Componentes/Motor/Carcaça/132M_RIGHT/132M_RIGHT.DXF
1941.6 x 1164.6
