MatheusParre/Bobinadeira/Componentes/Motor/Carcaça/132M_TOP/132M_TOP.DXF

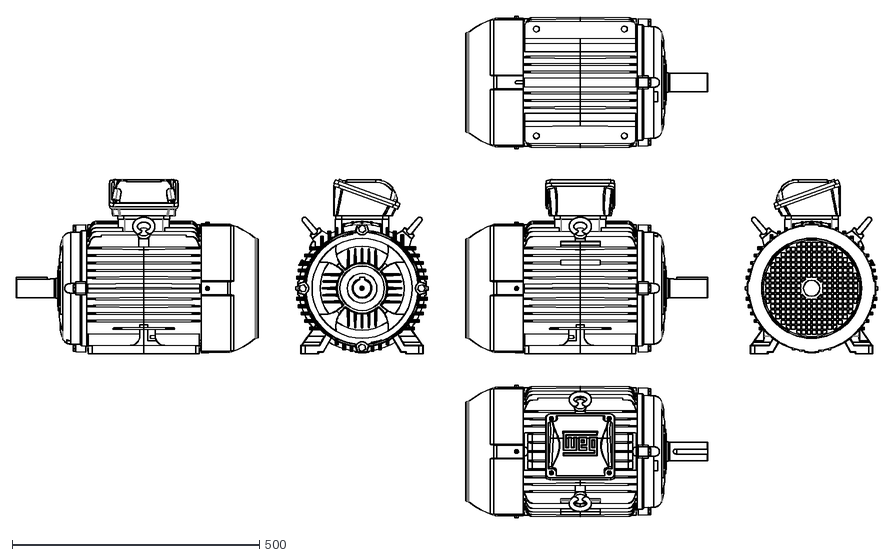
[picture p69: CAD file, 2021-09-08]
Componentes/Motor/Carcaça/132M_TOP/132M_TOP.DXF
1742.5 x 1014.2
