MatheusParre/Bobinadeira/(list of files, cad)

Other CAD files:
Componentes/Desenho de Conjunto/Desenho de Conjunto.dwg
Componentes/Eixo/Eixo.dwg
Componentes/Mancais e Rolamento/Mancal/Desenhos/SKF_SNL 524-620 + 1224 K + H 3024_top.dwg
Componentes/Mancais e Rolamento/Rolamento/Desenhos/SKF_1224 KM_top.dwg
Componentes/Polia Motora/Desenho Polia Motora.dwg
Componentes/Polia Movida/Polia Movida Correta.dwg
Componentes/Redutor/Redutor.DWG
Componentes/Mancais e Rolamento/Mancal/Desenhos/SKF_SNL 524-620 + 1224 K + H 3024_right.dwg
Componentes/Mancais e Rolamento/Rolamento/Desenhos/SKF_1224 KM_front.dwg
Componentes/Mancais e Rolamento/Mancal/Desenhos/SKF_SNL 524-620 + 1224 K + H 3024_front.dwg
Componentes/Mancais e Rolamento/Rolamento/Desenhos/SKF_1224 KM_right.dwg
Componentes/Polia Motora/Desenho Polia Motora.ipt
Componentes/Polia Movida/Polia Movida Correta.ipt
