MatheusParre/Bobinadeira/Componentes/Desenho de Conjunto/Desenho de Conjunto.pdf

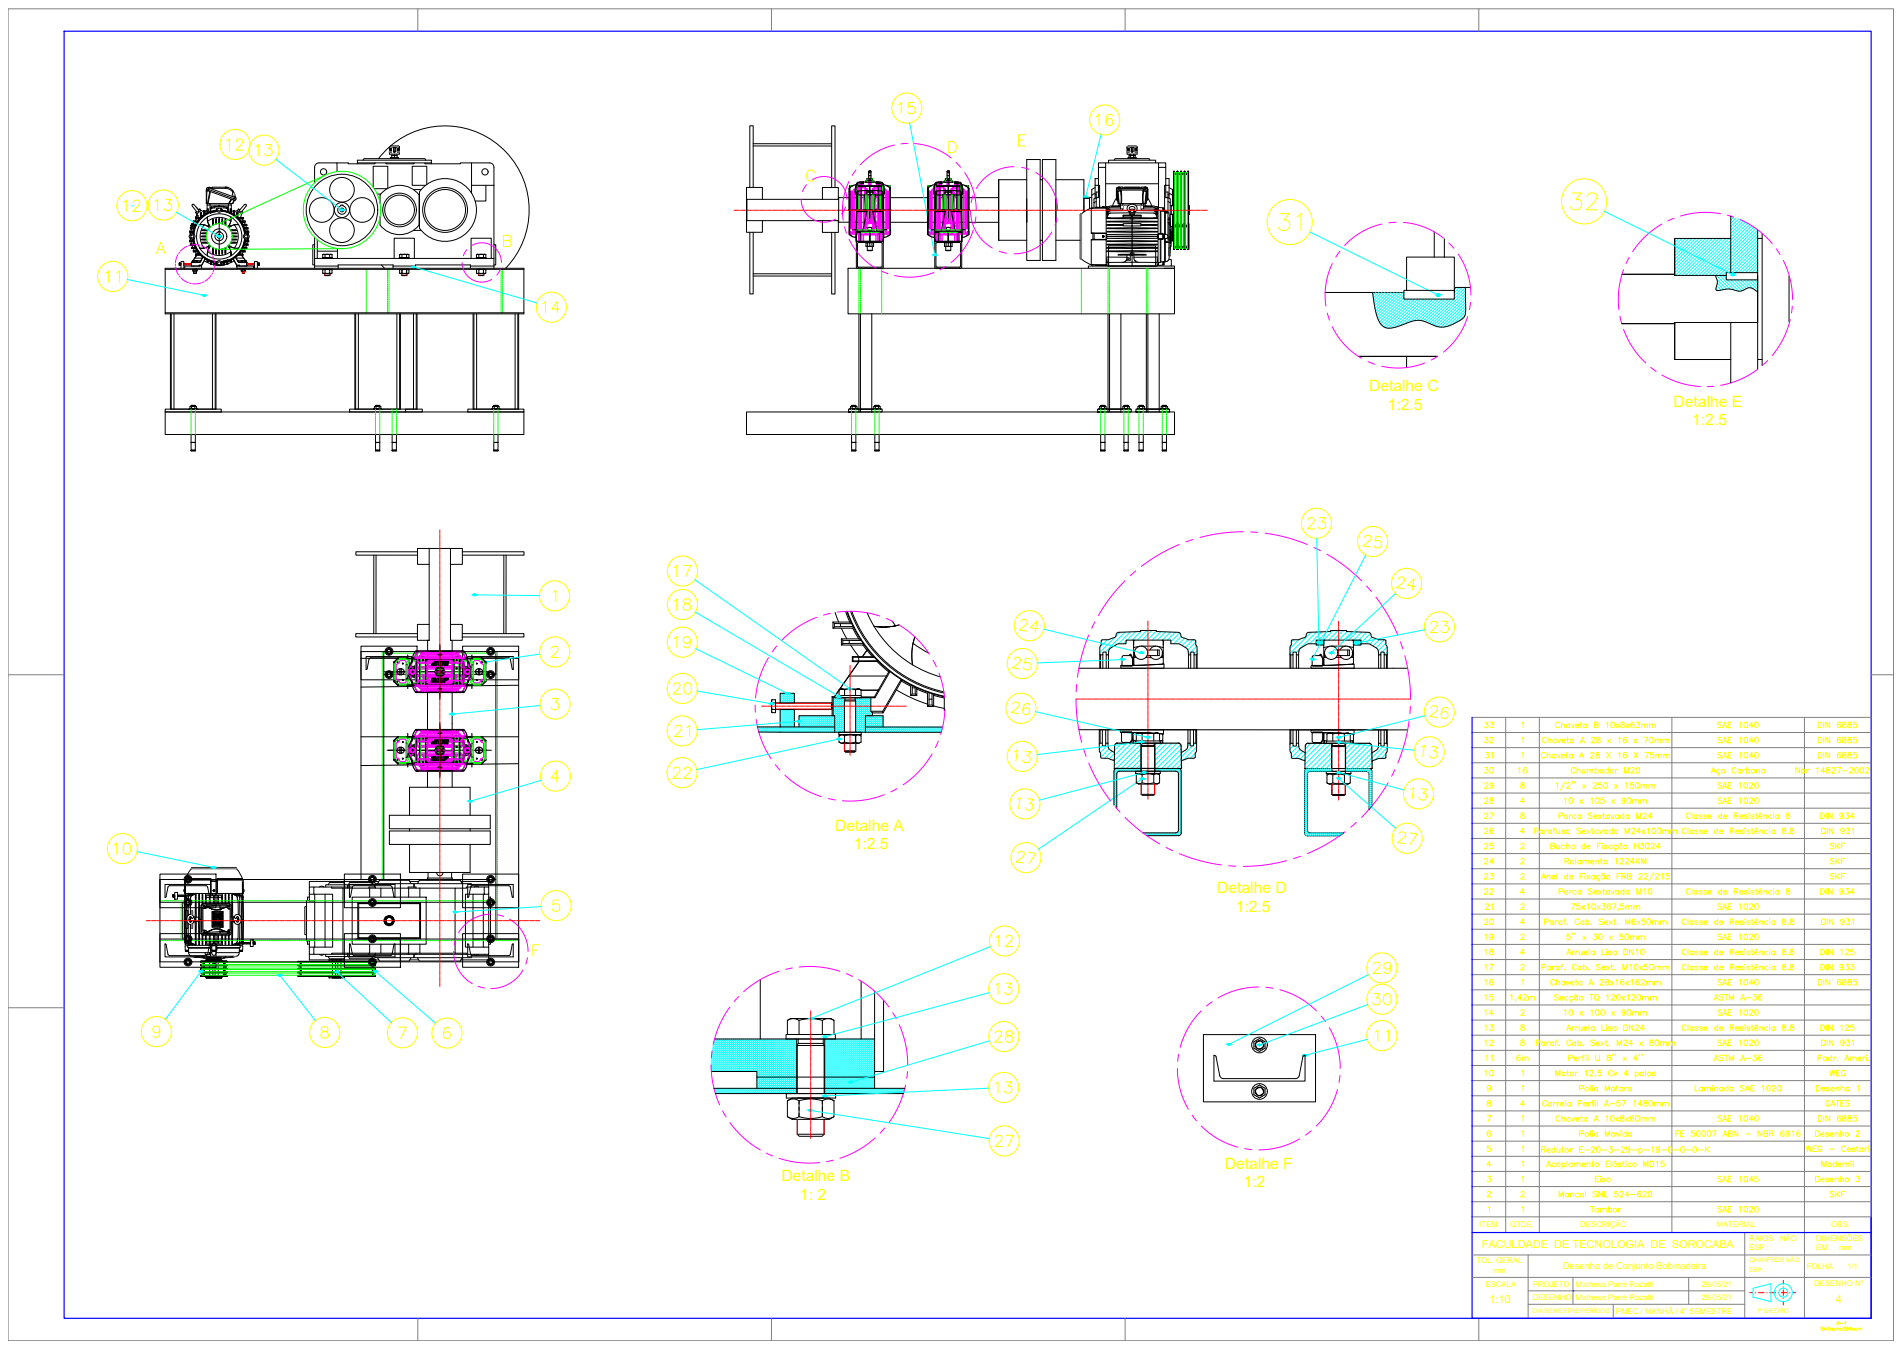
[picture p70: page 1]
Detalhe B 1: 2; Detalhe F; Detalhe A; Detalhe D; Detalhe E; Detalhe C

ITEM | QTDE. | DESCRIÇÃO | MATERIAL | OBS.
FACULDADE DE TECNOLOGIA DE SOROCABA | RAIOS NÃO ESP.: | DIMENSÕES EM mm

TOL. GERAL | Desenho de Conjunto Bobinadeira | CHANFROS NÃO ESP.: | 1/1 mm FOLHA

ESCALA 1:10 | PROJETO | Matheus Parré Rozatti | 29/05/21 | 1º DIEDRO | DESENHO Nº 4

DESENHO | Matheus Parré Rozatti | 29/05/21

DIA/SEMESTRE/PERÍODO | PMEC / MANHÃ / 4° SEMESTRE
