MatheusParre/Bobinadeira/Componentes/Eixo/Eixo-Modelo.pdf

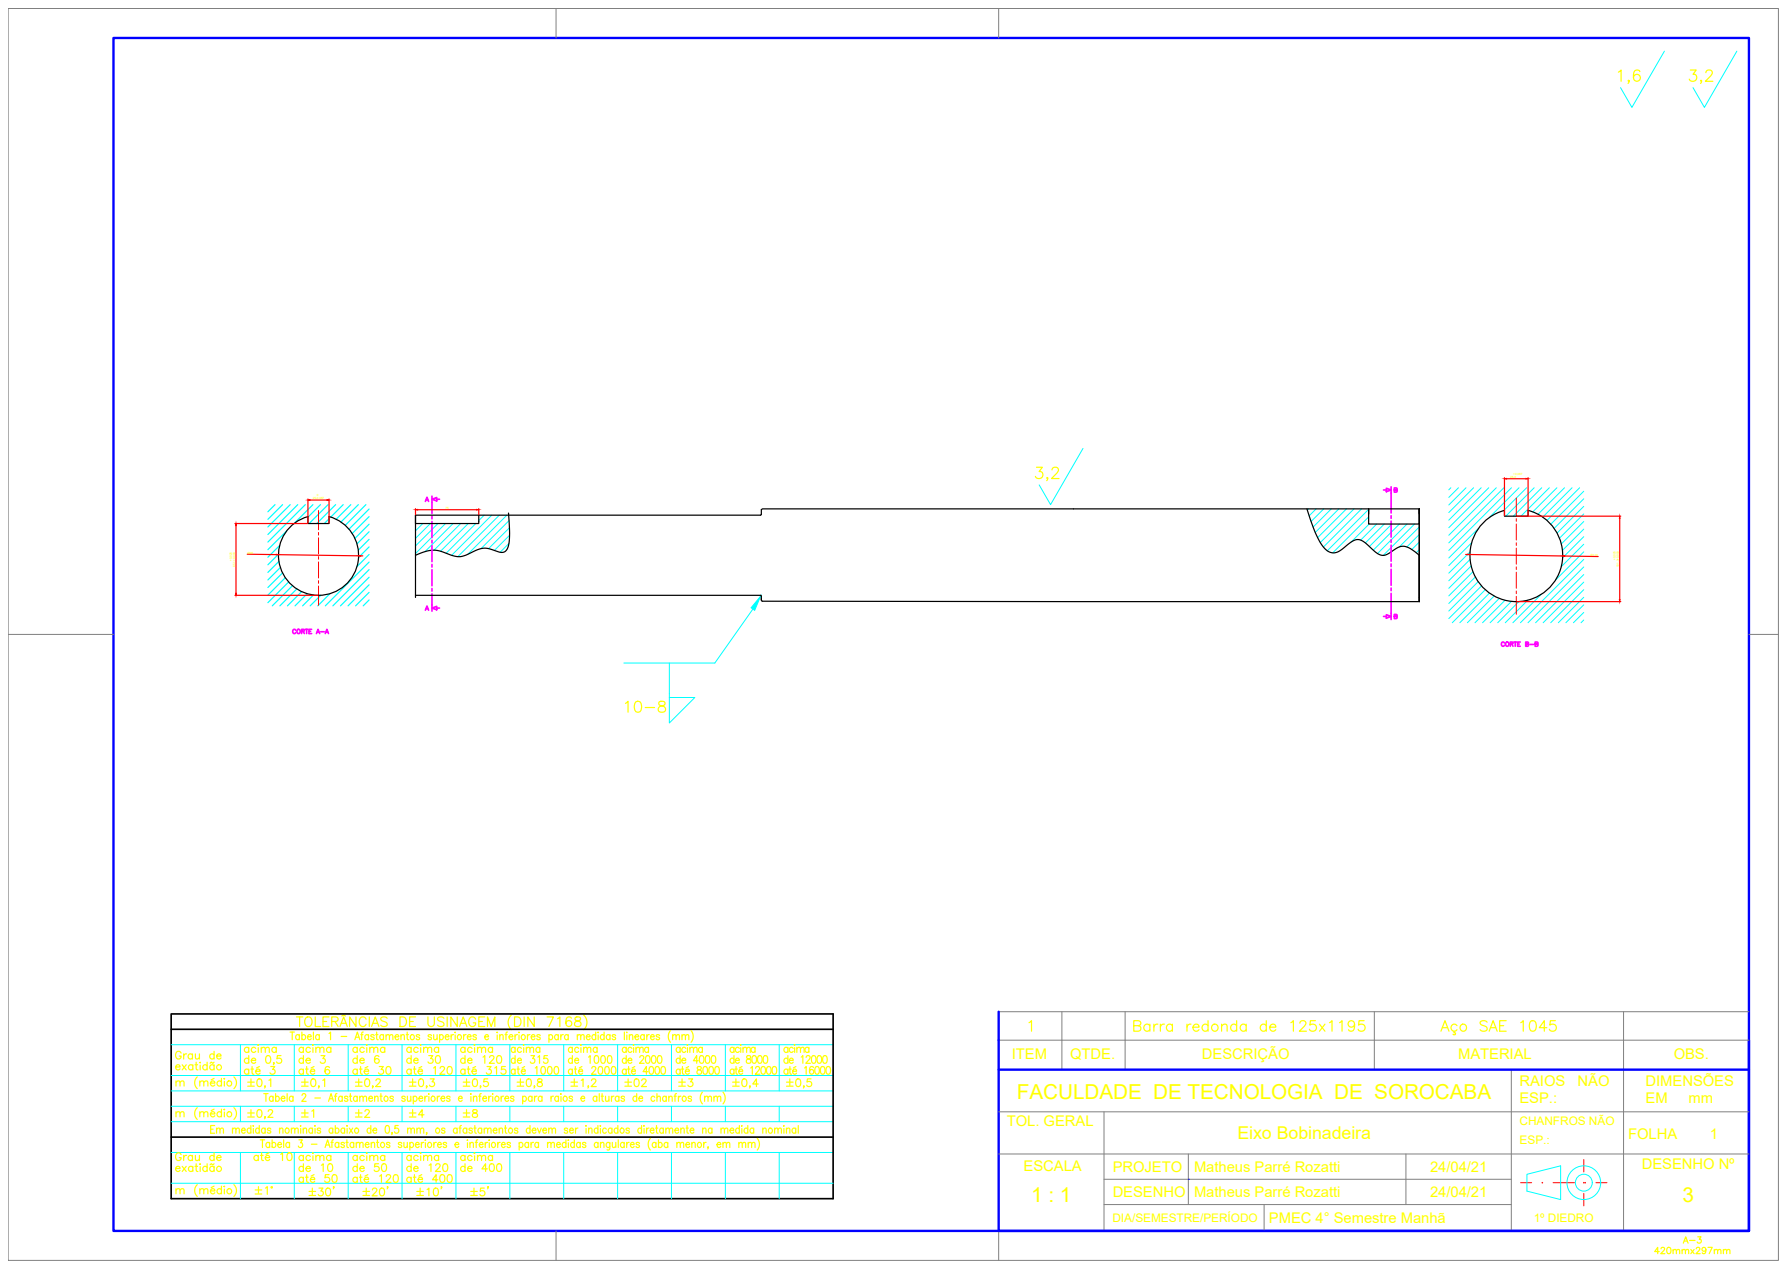
[picture p71: page 1]

ITEM | QTDE. | DESCRIÇÃO | MATERIAL | OBS.
FACULDADE DE TECNOLOGIA DE SOROCABA | RAIOS NÃO ESP.: | DIMENSÕES EM mm

TOL. GERAL | Eixo Bobinadeira | CHANFROS NÃO ESP.: | FOLHA 1

ESCALA 1 : 1 | PROJETO | Matheus Parré Rozatti | 24/04/21 | 1º DIEDRO | DESENHO Nº 3

DESENHO | Matheus Parré Rozatti | 24/04/21

DIA/SEMESTRE/PERÍODO | PMEC 4° Semestre Manhã
