MatheusParre/Bobinadeira/Componentes/Polia Motora/Desenho Polia Motora.pdf

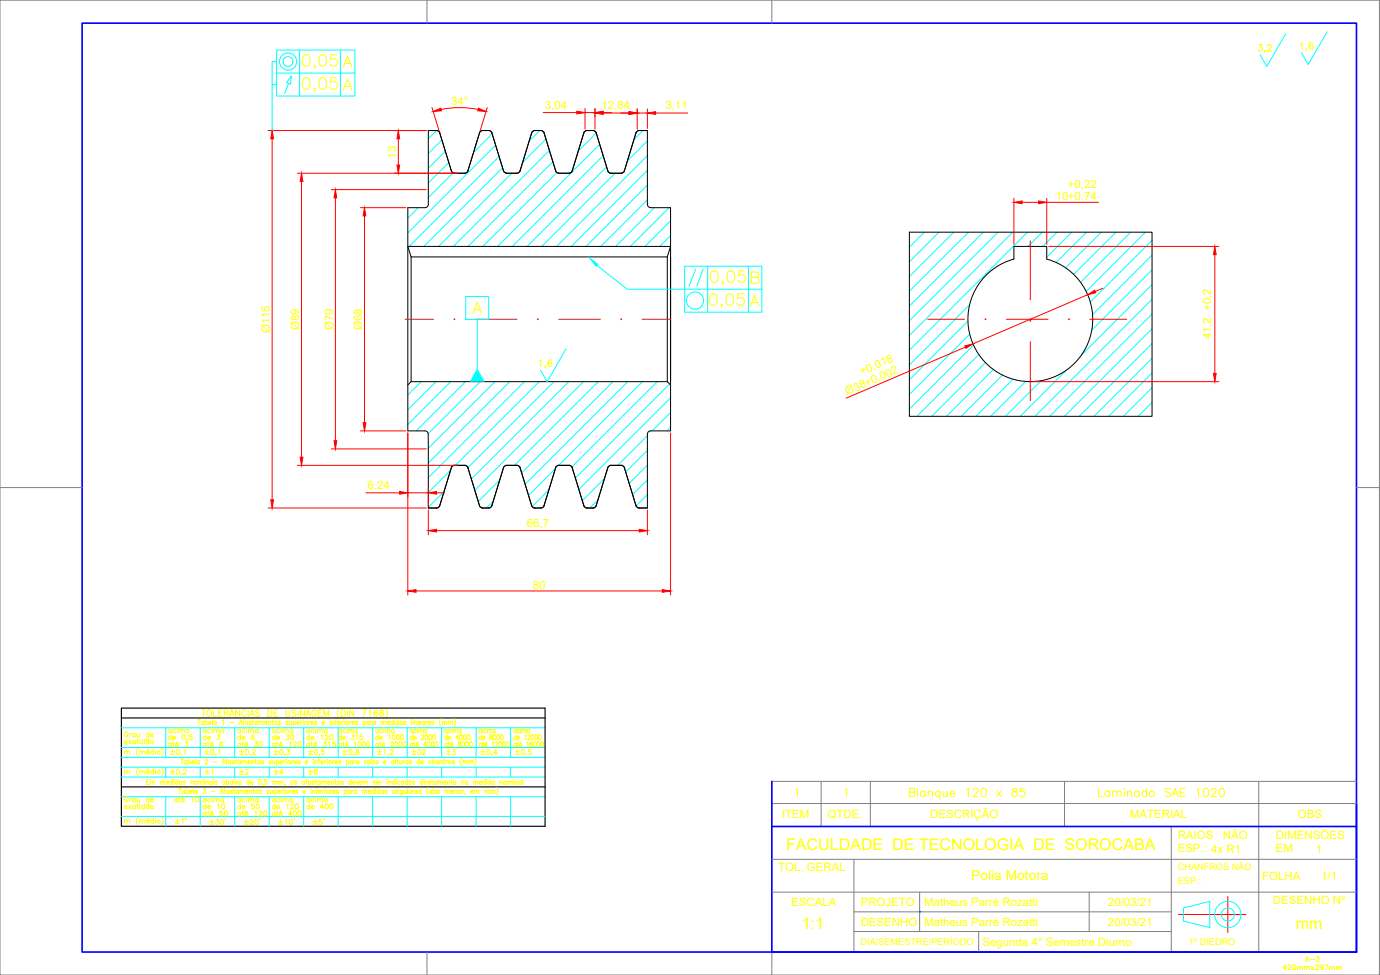
[picture p72: page 1]

ITEM | QTDE. | DESCRIÇÃO | MATERIAL | OBS.
FACULDADE DE TECNOLOGIA DE SOROCABA | RAIOS NÃO ESP.: 4x R1 | DIMENSÕES EM 1

TOL. GERAL | Polia Motora | CHANFROS NÃO ESP.: | FOLHA 1/1

ESCALA 1:1 | PROJETO | Matheus Parré Rozatti | 20/03/21 | 1º DIEDRO | DESENHO Nº mm

DESENHO | Matheus Parré Rozatti | 20/03/21

DIA/SEMESTRE/PERÍODO | Segunda 4° Semestre Diurno
