MatheusParre/Bobinadeira/Componentes/Polia Movida/Polia Movida Correta.pdf

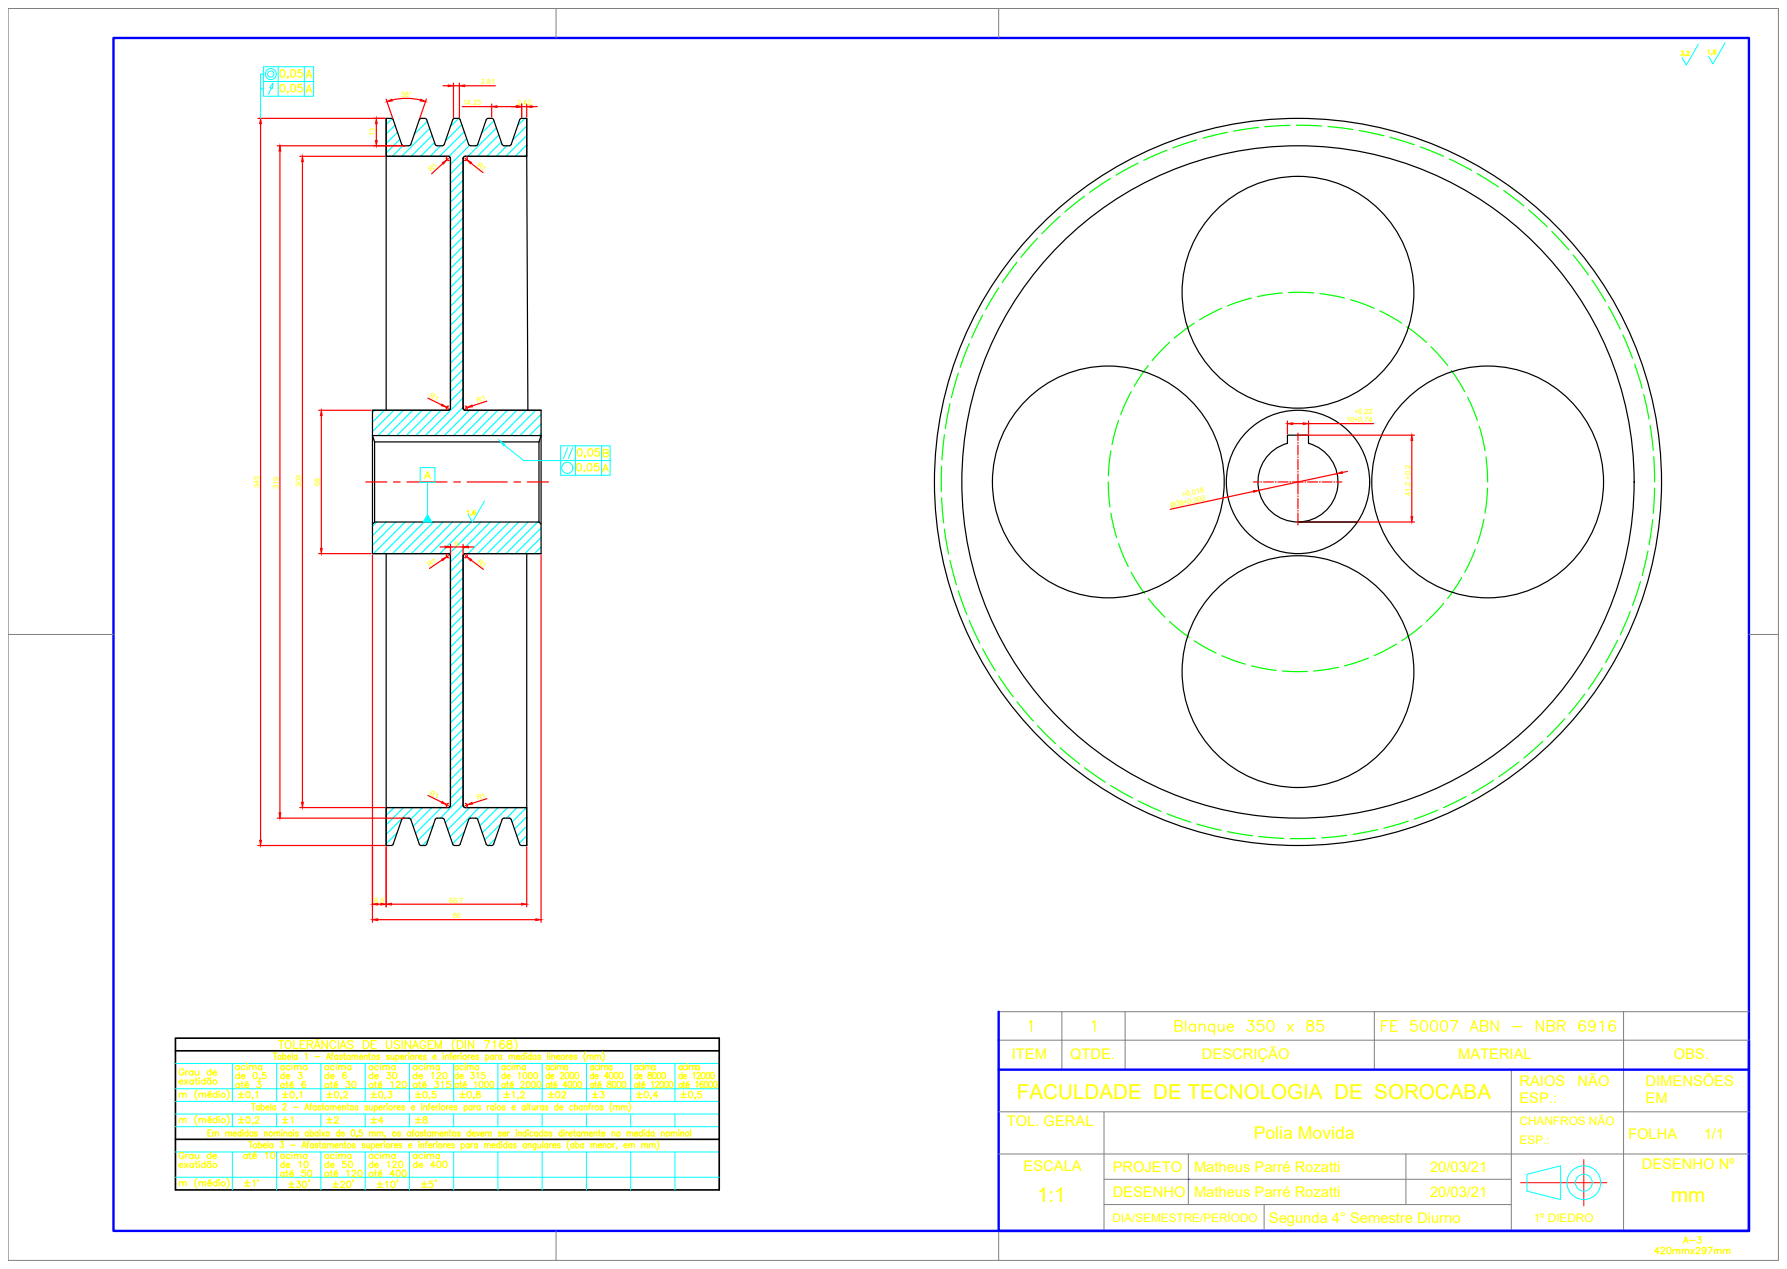
[picture p73: page 1]
Matheus Parré Rozatti

ITEM | QTDE. | DESCRIÇÃO | MATERIAL | OBS.
FACULDADE DE TECNOLOGIA DE SOROCABA | RAIOS NÃO ESP.: | DIMENSÕES EM

TOL. GERAL | Polia Movida | CHANFROS NÃO ESP.: | FOLHA 1/1

ESCALA 1:1 | PROJETO | | | 1º DIEDRO | DESENHO Nº mm

DESENHO | Matheus Parré Rozatti | 20/03/21

DIA/SEMESTRE/PERÍODO | Segunda 4° Semestre Diurno
