MatheusParre/Bobinadeira/Desenhos/Desenho Polia Motora.pdf

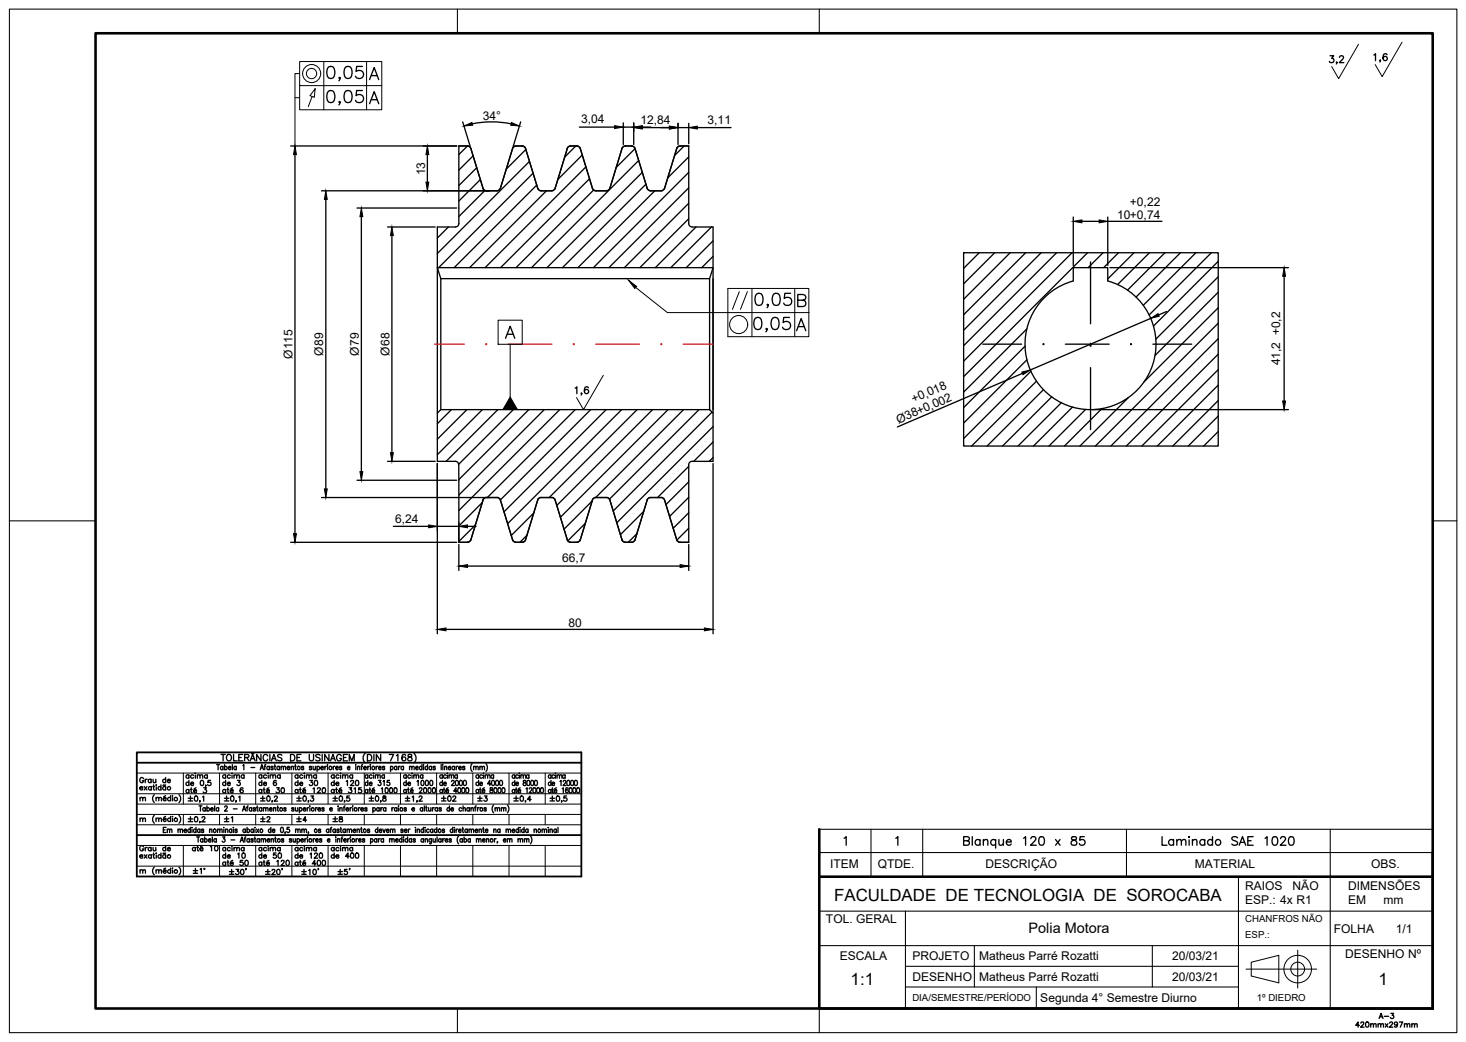
[picture p74: page 1]
ESCALA; PROJETO; DESENHO Nº DIA/SEMESTRE/PERÍODO DESENHO; 1º DIEDRO FACULDADE DE TECNOLOGIA DE SOROCABA TOL. GERAL ITEM; QTDE.; DESCRIÇÃO; RAIOS NÃO; DIMENSÕES CHANFROS NÃO ESP.:; FOLHA ESP.:; EM MATERIAL; OBS. mm1/1 4x R1 Polia Motora; 1 Segunda 4° Semestre Diurno 1:1; Matheus Parré Rozatti Matheus Parré Rozatti
