MatheusParre/Bobinadeira/Desenhos/Eixo.pdf

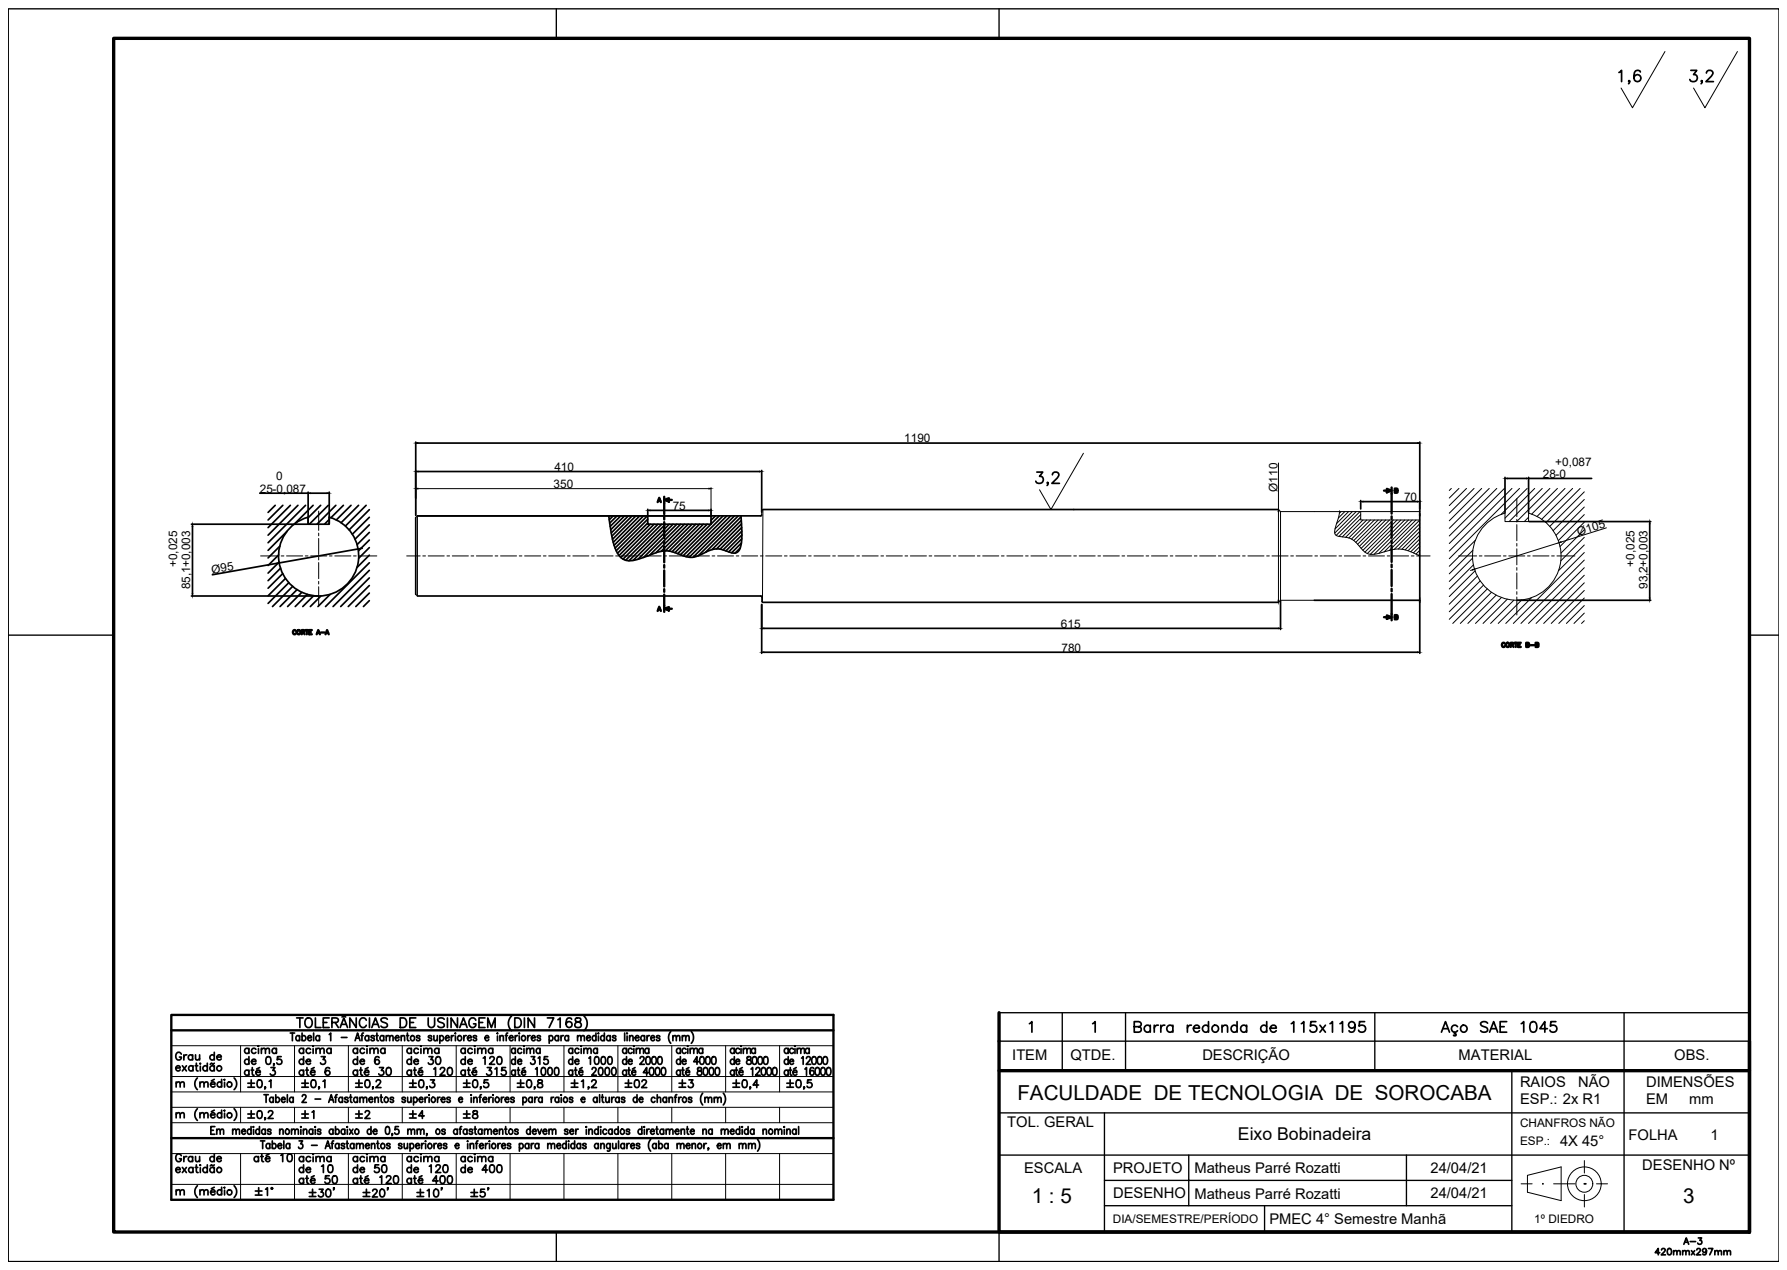
[picture p75: page 1]
ESCALA; PROJETO; DESENHO Nº DIA/SEMESTRE/PERÍODO DESENHO; 1º DIEDRO FACULDADE DE TECNOLOGIA DE SOROCABA TOL. GERAL ITEM; QTDE.; DESCRIÇÃO; RAIOS NÃO; DIMENSÕES CHANFROS NÃO ESP.:; FOLHA ESP.:; EM MATERIAL; OBS. mm1 2x R1 Eixo Bobinadeira; 3 PMEC 4° Semestre Manhã 1 : 5; Matheus Parré Rozatti Matheus Parré Rozatti
