MatheusParre/Bobinadeira/Desenhos/Polia Movida .pdf

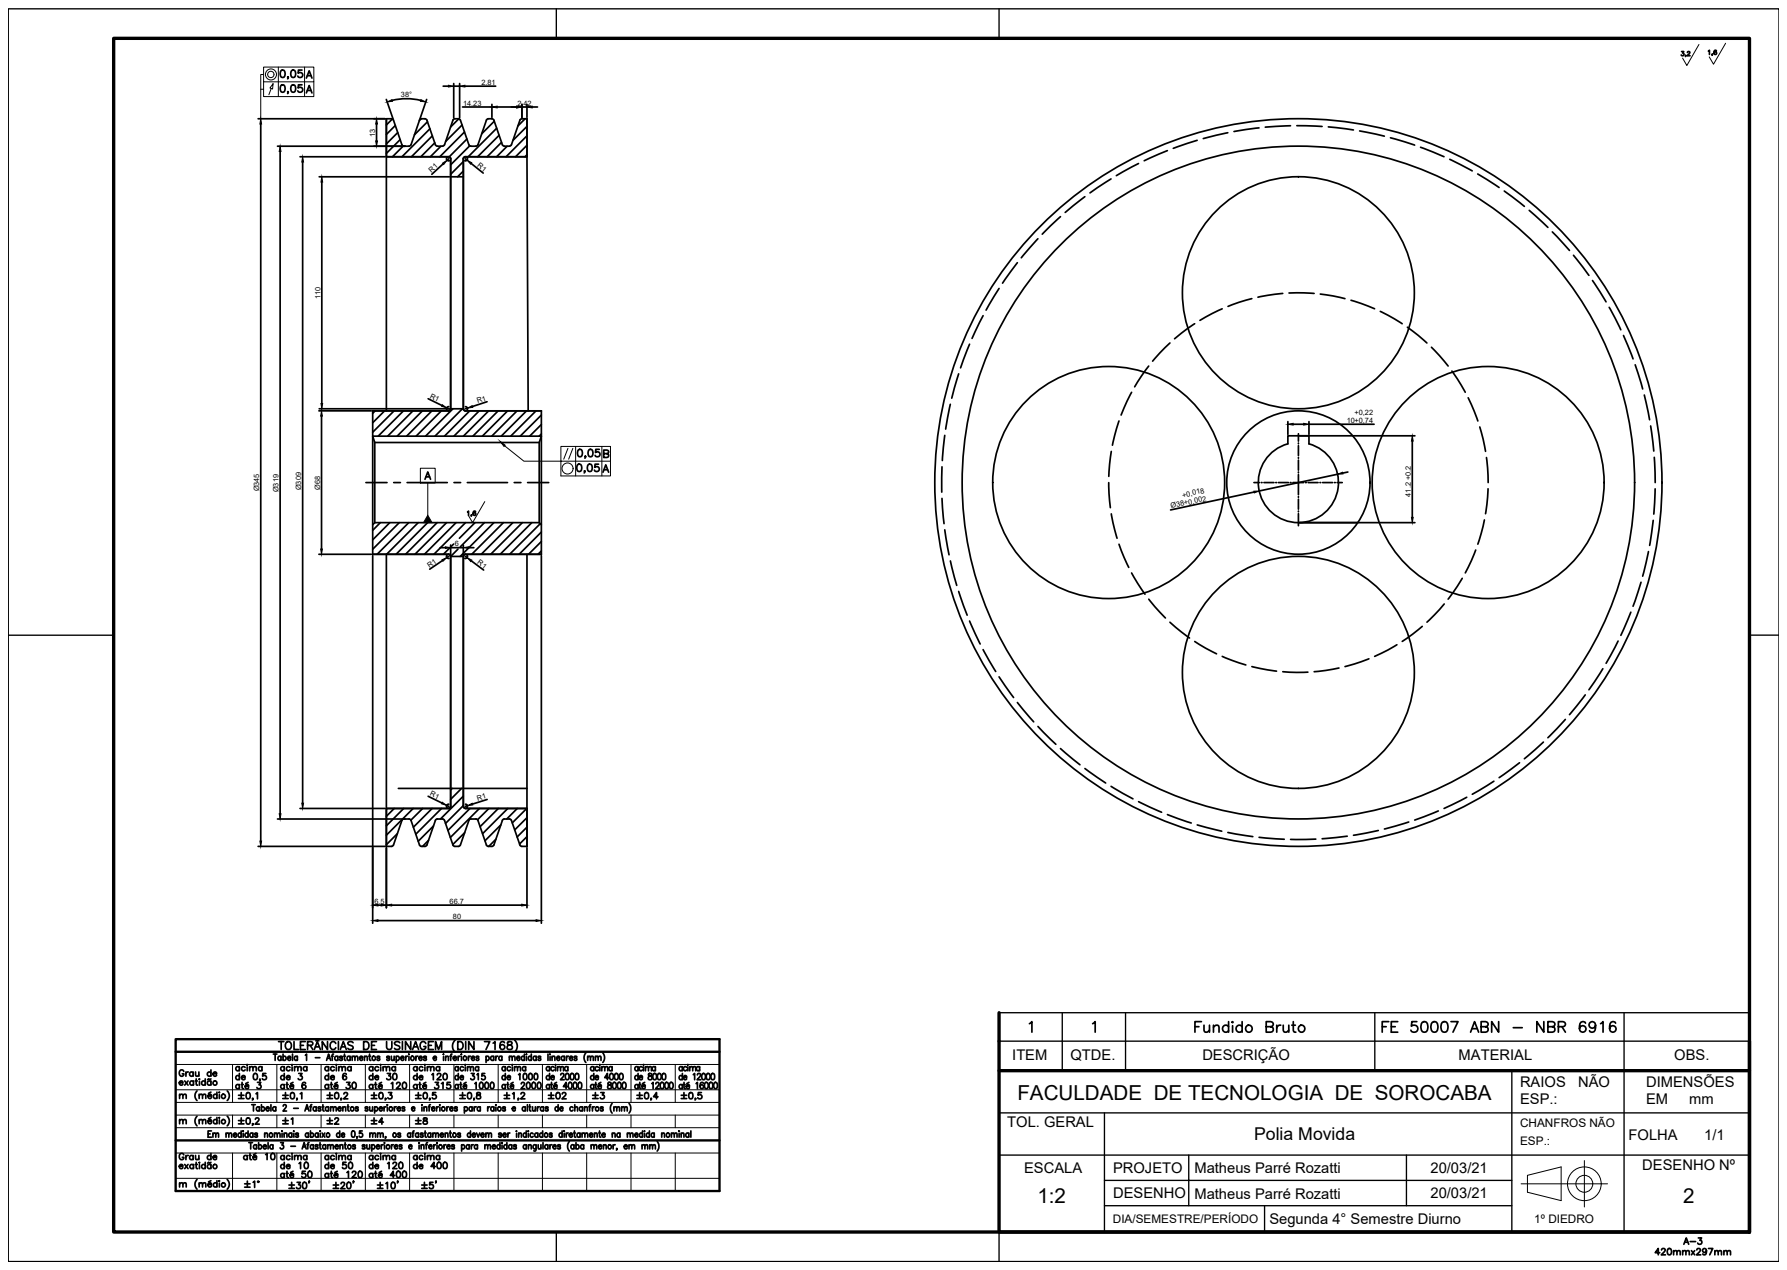
[picture p76: page 1]
ESCALA; PROJETO; DESENHO Nº DIA/SEMESTRE/PERÍODO DESENHO; 1º DIEDRO FACULDADE DE TECNOLOGIA DE SOROCABA TOL. GERAL ITEM; QTDE.; DESCRIÇÃO; RAIOS NÃO; DIMENSÕES CHANFROS NÃO ESP.:; FOLHA ESP.:; EM MATERIAL; OBS. mm Polia Movida; 2 Segunda 4° Semestre Diurno 1:2; Matheus Parré Rozatti Matheus Parré Rozatti
