MatheusParre/Bobinadeira/Componentes/Motor/Desenho Motor.pdf

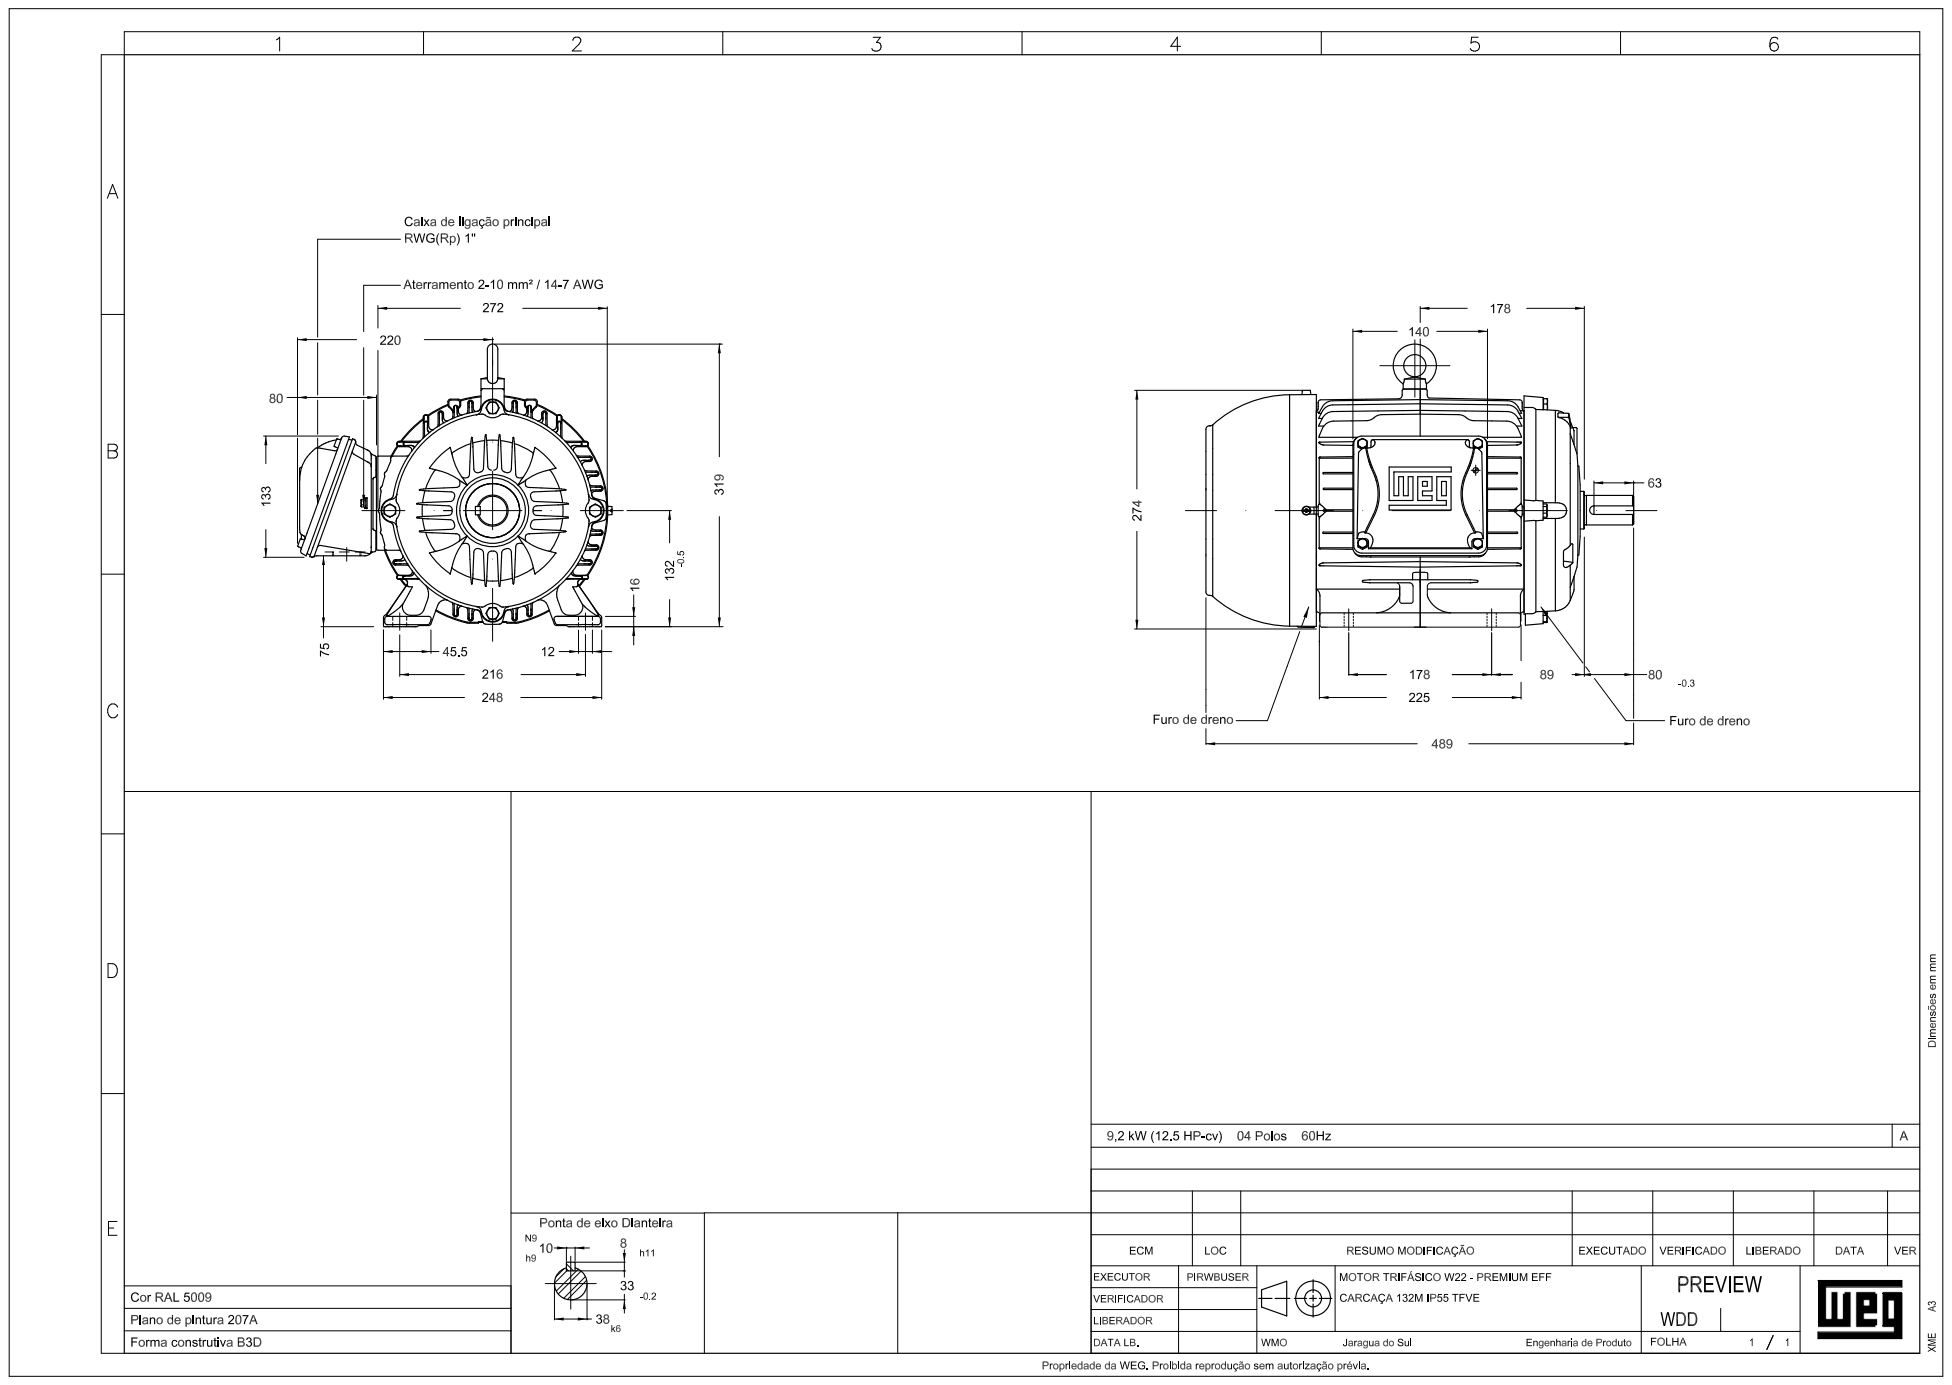
[picture p77: page 1]
