MatheusParre/Bobinadeira/Desenhos/Desenho de Conjunto.pdf

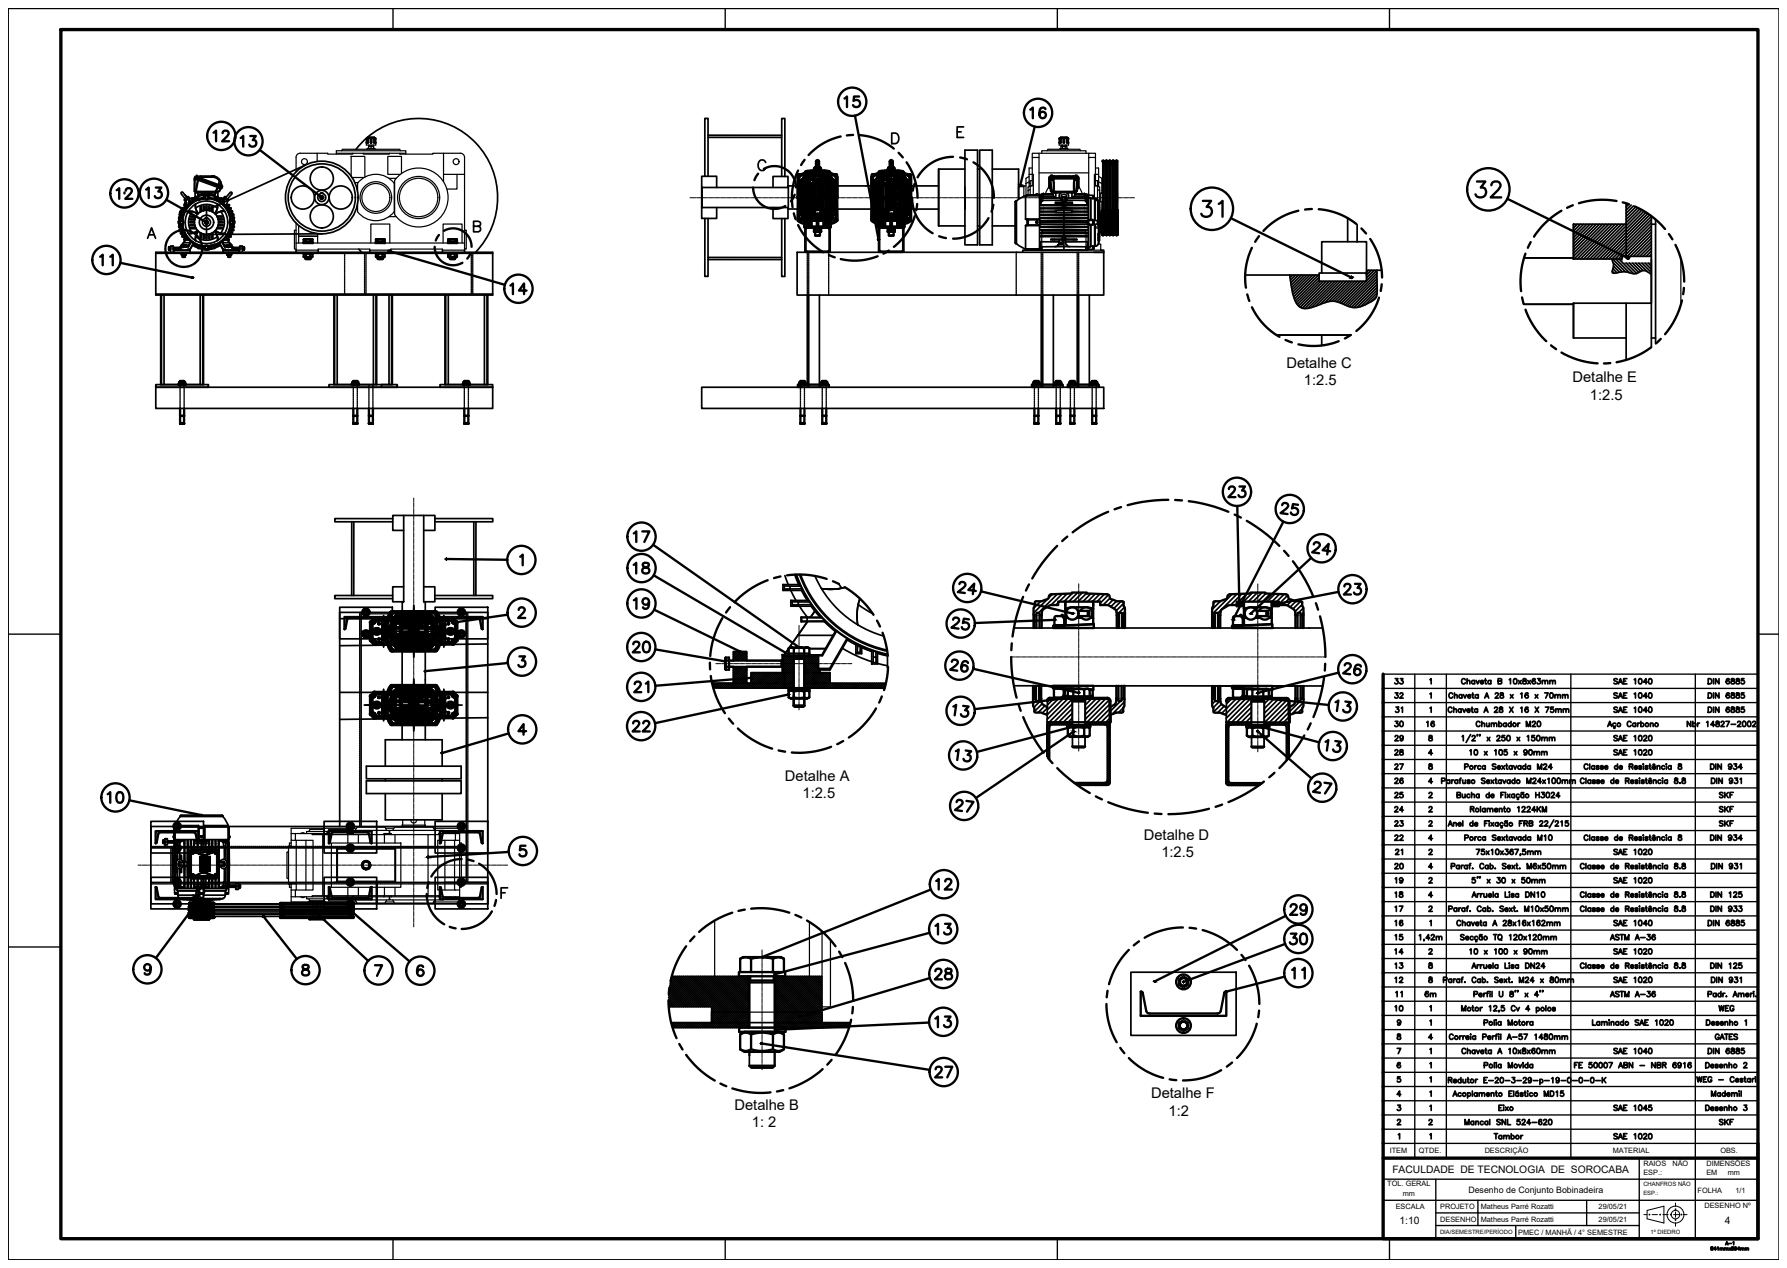
[picture p78: page 1]
ESCALA; PROJETO; DESENHO Nº DIA/SEMESTRE/PERÍODO DESENHO; 1º DIEDRO FACULDADE DE TECNOLOGIA DE SOROCABA TOL. GERAL ITEM; QTDE.; DESCRIÇÃO; RAIOS NÃO; DIMENSÕES CHANFROS NÃO ESP.:; FOLHA ESP.:; EM MATERIAL; OBS. mm Desenho de Conjunto Bobinadeira; 4 PMEC / MANHÃ / 4° SEMESTRE 1:10; Matheus Parré Rozatti Matheus Parré Rozatti; 29/05/21 Detalhe B 1: 2; Detalhe F 1:2 Detalhe A 1:2.5; Detalhe D 1:2.5; Detalhe E 1:2.5 Detalhe C 1:2.5
