MatheusParre/Bobinadeira/(commit log)

2021-09-08 Adição do Projeto
    [132M_LEFT.DXF, 132M_RIGHT.DXF, 132M_TOP.DXF, Desenho Polia Motora.dwg, Desenho Polia Motora.ipt, Desenho de Conjunto.dwg, Eixo.dwg, Polia Movida Correta.dwg]
2021-09-08 Correção da estrutura de pastas
    [132M_LEFT.DXF, 132M_RIGHT.DXF, 132M_TOP.DXF, Desenho Polia Motora.dwg, Desenho Polia Motora.ipt, Desenho de Conjunto.dwg, Eixo.dwg, Polia Movida Correta.dwg]
